jeremiasadrian/MIB_sistema_p_realimentacion_haptica/Esquematicos-y-PCB/Proyecto_KiCAD_Control-y-fuente-de-corriente/bom/BOM_Planilla.ods

N.º | Referencias | Valor | Footprint | Cantidad | Datasheet | Código Proveedor
1 | R1, R5 | 10k | R_Axial_DIN0207_L6.3mm_D2.5mm_P10.16mm_Horizontal | 2
2 | R2 | 22k | R_Axial_DIN0207_L6.3mm_D2.5mm_P10.16mm_Horizontal | 1
3 | R3 | 6k8 | R_Axial_DIN0207_L6.3mm_D2.5mm_P10.16mm_Horizontal | 1
4 | R4 | 47k | R_Axial_DIN0207_L6.3mm_D2.5mm_P10.16mm_Horizontal | 1
5 | R6 | 3k3 | R_Axial_DIN0207_L6.3mm_D2.5mm_P10.16mm_Horizontal | 1
6 | D1, D2 | 1N4148 | D_DO-41_SOD81_P7.62mm_Horizontal | 2
7 | U1 | LCD-016N002L | LCD_pinsonly | 1
8 | U2 | PSoC4_kit049_(CY8C4245AXI-483) | PinSocket_2x22_P2.54mm_Vertical_2 | 1
9 | U3 | TL082 | DIP-8_W10.16mm_LongPads | 1
10 | SW1, SW2 | SW_Push | SW_PUSH_6mm_H7.3mm | 2
11 | Q1, Q4, Q6 | BF422 | BF42X | 3
12 | Q2, Q3, Q5 | BF421 | BF42X | 3
13 | RV1, RV4 | 5k | Potentiometer_Bourns_3296W_Vertical | 2
14 | RV2 | 2k | Potentiometer_Bourns_3296W_Vertical | 1
15 | RV3 | 10k | Potentiometer_Bourns_3296W_Vertical | 1
16 | J1, J5 | Conn_01x01_Male | PinHeader_1x01_P2.54mm_Horizontal | 2
17 | J2, J3 | Screw_Terminal_01x01 | TerminalBLock_bornier-1_P5.08mm | 2
18 | J4 | Screw_Terminal_01x04 | TerminalBlock_bornier-4_P5.08mm | 1
