jeremiasadrian/MIB_sistema_p_realimentacion_haptica/Esquematicos-y-PCB/Proyecto_KiCAD_Control-y-fuente-de-corriente/Control_Fuente_de_Corrientes.step

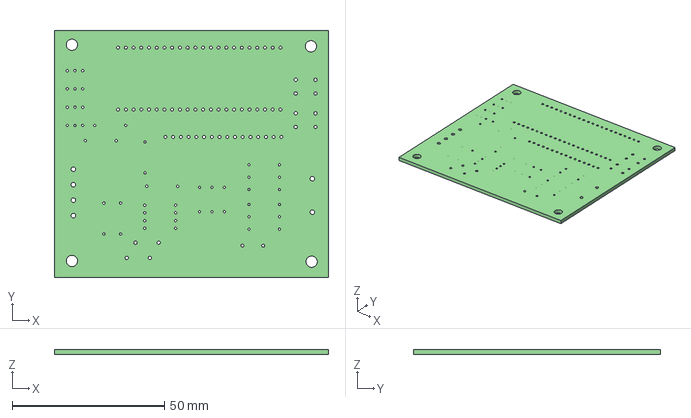
[picture p9: CAD file, 2024-03-17]
Esquematicos-y-PCB/Proyecto_KiCAD_Control-y-fuente-de-corriente/Control_Fuente_de_Corrientes.step
90.0 x 81.2 x 1.60 mm
