jeremiasadrian/MIB_sistema_p_realimentacion_haptica/Resultados/Pruebas/Caracterización del Nucleo de Ferrita (grande ATX).xlsx

N | N^2 | L
45 | 2025 | 4
65 | 4225 | 8.92
85 | 7225 | 17.75
105 | 11025 | 29.66
125 | 15625 | 36
150 | 22500 | 54
175 | 30625 | 76.9
200 | 40000 | 104
240 | 57600 | 162
