jeremiasadrian/MIB_sistema_p_realimentacion_haptica/Resultados/Pruebas/Regulación de Fuente de AT.xlsx

Relevamiento con ARD-UNO a 500Hz y 70% de DC.
N° | Vo+ (V) | Io (mA) | Rl (calc) | Po (mW) | Icc (A) | Vcc (V) | Pcc (W) | V+ (Rs) | V- (Rs)
1 | 317 | 1.67 | 189820.3593 | 529.39 | 0.28 | 12 | 3.36 | 2.16 | 2.64 | MAX
2 | 275 | 2.03 | 135467.9803 | 558.25 | 0.39 | 12 | 4.68 | 3.6 | 3.76
3 | 247 | 2.22 | 111261.2613 | 548.34 | 0.46 | 12 | 5.52 | 4.8 | 4.6 | Rango útil
4 | 217 | 2.4 | 90416.66667 | 520.8 | 0.59 | 12 | 7.08 | 6.2 | 5.8
5 | 191 | 2.59 | 73745.17375 | 494.69 | 0.64 | 12 | 7.68 | 6.8 | 6.2
6 | 166 | 2.86 | 58041.95804 | 474.76 | 0.7 | 12 | 8.4 | 7.4 | 7
7 | 117 | 3.46 | 33815.0289 | 404.82 | 0.8 | 12 | 9.6 | 8.4 | 8.2
8 | 93 | 4.05 | 22962.96296 | 376.65 | 0.84 | 12 | 10.08 | 8.8 | 8.8
9 | 0.75 | 12.73 | 58.91594658 | 9.5475 | 0.99 | 12 | 11.88 | 10.2 | 10.8 | MIN
Relevamiento con SG3525 (lazo abierto) a 85Hz y 300us de DT.
N° | Vo+ (V) | Io (mA) | Rl (calc) | Po (mW) | Icc (A) | Vcc (V) | Pcc (W) | V+ (Rs) | V- (Rs)
1 | 313 | 1.29 | 242635.6589 | 403.77 | 0.4 | 12 | 4.8 | 2.2 | 2.2 | MAX | picos de 8
2 | 304 | 1.52 | 200000 | 462.08 | 0.414 | 12 | 4.968 | 3 | 2.5
3 | 263 | 2.02 | 130198.0198 | 531.26 | 0.58 | 12 | 6.96 | 5 | 4 | Rango útil
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
