jeremiasadrian/MIB_sistema_p_realimentacion_haptica/Resultados/Pruebas/Respuesta de Opto 4N26A.xlsx

Punto | Vba (volt) | Ii (uA) | Vc (volt)
1 | 1 | 67.5 | 12.93
2 | 1.1 | 102 | 12.81
3 | 1.2 | 145.8 | 12.64
4 | 1.3 | 186.6 | 12.43
5 | 1.4 | 226.5 | 12.23
6 | 1.5 | 271.5 | 11.92
7 | 1.6 | 324.8 | 11.55
8 | 1.7 | 377.7 | 11.18
9 | 1.8 | 418.6 | 10.88
10 | 1.9 | 465.8 | 10.5
11 | 2 | 504.7 | 10.19
12 | 2.1 | 554.1 | 9.76
13 | 2.2 | 604 | 9.33
14 | 2.3 | 657 | 8.84
15 | 2.4 | 704 | 8.42
16 | 2.5 | 745 | 8.04
17 | 2.6 | 798 | 7.52
18 | 2.7 | 844 | 7.09
19 | 2.8 | 894 | 6.6
20 | 2.9 | 940 | 6.16
21 | 3 | 990 | 5.68
22 | 3.1 | 1038 | 5.2
23 | 3.2 | 1089 | 4.72
24 | 3.3 | 1130 | 4.32
25 | 3.4 | 1189 | 3.76
26 | 3.5 | 1233 | 3.33
27 | 3.6 | 1273 | 2.94
28 | 3.7 | 1326 | 2.4
29 | 3.8 | 1384 | 1.9
30 | 3.9 | 1426 | 1.48
31 | 4 | 1480 | 0.98
32 | 4.1 | 1521 | 0.72
33 | 4.2 | 1565 | 0.59
34 | 4.3 | 1620 | 0.52
35 | 4.4 | 1680 | 0.47
36 | 4.5 | 1721 | 0.44
37 | 4.6 | 1767 | 0.42
38 | 4.7 | 1826 | 0.39
39 | 4.8 | 1865 | 0.37
40 | 4.9 | 1922 | 0.35
41 | 5 | 1968 | 0.34
