jeremiasadrian/MIB_sistema_p_realimentacion_haptica/Resultados/Pruebas/Relevamiento para linealización FSR.xlsx

n | Pn (gr) | PnT (gr) | Rn | Rcn
1 | 0 | 7.54 | 8300000 | - | Peso de la plataforma (gr):
2 | 2 | 9.54 | 1100000 | - | 7.54
3 | 5 | 12.54 | 160000 | 989
4 | 10 | 17.54 | 88000 | 983
5 | 20 | 27.54 | 60500 | 977
6 | 50 | 57.54 | 21300 | 954
7 | 70 | 77.54 | 15900 | 944
8 | 100 | 107.54 | 13500 | 923
9 | 150 | 157.54 | 10000 | -
10 | 200 | 207.54 | 7300 | -
11 | 300 | 307.54 | 6200 | -
12 | 400 | 407.54 | 5350 | -
13 | 500 | 507.54 | 4650 | -
14 | 600 | 607.54 | 4250 | -
Linealización pasiva con R paralelo.
Ra | 160000
Rb | 13500
Rj | 60500
p | 0.84
 |  | RL | 984.0
Linealización activa con divisor resistivo.
n | Pn (gr) | PnT (gr) | V1n (1,014M pull-u) | V1n (1,014M pull-d) | V2n (476k pull-u) | V2n (476k pull-d) | V3n (99,3k pull-u) | V3n (99,3k pull-d)
1 | 0 | 0 | 4.583 | 0 | 4.796 | 0 | 4.956 | 0
2 | 0 | 7.54 | 1.6 | 3.9 | 1.83 | 2.7 | 3.55 | 2
3 | 2 | 9.54 | 1.25 | 4.34 | 1.2 | 3.5 | 2.95 | 2.6
4 | 5 | 12.54 | 0.8 | 4.59 | 0.8 | 3.95 | 2.36 | 3
5 | 10 | 17.54 | 0.52 | 4.71 | 0.56 | 4.36 | 2.18 | 3.29
6 | 20 | 27.54 | 0.315 | 4.76 | 0.39 | 4.59 | 1.42 | 3.68
7 | 50 | 57.54 | 0.134 | 4.86 | 0.26 | 4.73 | 0.95 | 4
8 | 100 | 107.54 | 0.088 | 4.92 | 0.173 | 4.865 | 0.67 | 4.3
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
