jeremiasadrian/MIB_sistema_p_realimentacion_haptica/Resultados/Pruebas/RelevVDAC 1SEG.xls

Sheet: Vo (t=1seg)
recFunction | recValue | recUnit | recTime
DCV | 0 | mV | 22:14:58
DCV | 3.2 | mV | 22:14:58
DCV | 6.2 | mV | 22:14:59
DCV | 6.6 | mV | 22:15:00
DCV | 6.9 | mV | 22:15:00
DCV | 7.4 | mV | 22:15:01
DCV | 7.5 | mV | 22:15:01
DCV | 7.6 | mV | 22:15:02
DCV | 7.7 | mV | 22:15:03
DCV | 7.7 | mV | 22:15:03
DCV | 7.8 | mV | 22:15:04
DCV | 7.8 | mV | 22:15:04
DCV | 8 | mV | 22:15:05
DCV | 8.2 | mV | 22:15:06
DCV | 8.6 | mV | 22:15:06
DCV | 9.1 | mV | 22:15:07
DCV | 11.3 | mV | 22:15:07
DCV | 14.9 | mV | 22:15:08
DCV | 21.5 | mV | 22:15:09
DCV | 36.7 | mV | 22:15:09 |  | 15.2
DCV | 46.7 | mV | 22:15:10 |  | 10
DCV | 59.2 | mV | 22:15:10 |  | 12.5
DCV | 70.3 | mV | 22:15:11 |  | 11.1
DCV | 82.1 | mV | 22:15:11 |  | 11.8
DCV | 99.7 | mV | 22:15:12 |  | 17.6
DCV | 115.9 | mV | 22:15:13 |  | 16.2
DCV | 123.4 | mV | 22:15:13 |  | 7.5
DCV | 141.3 | mV | 22:15:14 |  | 17.9
DCV | 154.7 | mV | 22:15:14 |  | 13.4
DCV | 164.2 | mV | 22:15:15 |  | 9.5
DCV | 176.5 | mV | 22:15:16 |  | 12.3
DCV | 185.4 | mV | 22:15:16 |  | 8.9
DCV | 201.4 | mV | 22:15:17 |  | 16
DCV | 213.7 | mV | 22:15:17 |  | 12.3
DCV | 231 | mV | 22:15:18 |  | 17.3
DCV | 235.1 | mV | 22:15:19 |  | 4.1
DCV | 252.5 | mV | 22:15:19 |  | 17.4
DCV | 265.4 | mV | 22:15:20 |  | 12.9
DCV | 277.4 | mV | 22:15:20 |  | 12
DCV | 287.6 | mV | 22:15:21 |  | 10.2
DCV | 299.9 | mV | 22:15:21 |  | 12.3
DCV | 317.2 | mV | 22:15:22 |  | 17.3
DCV | 331.4 | mV | 22:15:23 |  | 14.2
DCV | 338.9 | mV | 22:15:23 |  | 7.5
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
DCV | 4,654 | V | 22:27:32
DCV | 4,655 | V | 22:27:33
DCV | 4,677 | V | 22:27:33
DCV | 4,677 | V | 22:27:34
DCV | 4,697 | V | 22:27:35
DCV | 4,697 | V | 22:27:35
DCV | 4,717 | V | 22:27:36
DCV | 4,718 | V | 22:27:36
DCV | 4,737 | V | 22:27:37
DCV | 4,739 | V | 22:27:38
DCV | 4,757 | V | 22:27:38

Sheet: Ii (t=1seg)
recItem | recFunction | recValue | recUnit | recTime
1 | DCA | 2.2 | uA | 21:57:15
2 | DCA | 2.2 | uA | 21:57:16
3 | DCA | 4.5 | uA | 21:57:16 |  | 2.3
4 | DCA | 6.3 | uA | 21:57:17 |  | 1.8
5 | DCA | 6.5 | uA | 21:57:17
6 | DCA | 9.1 | uA | 21:57:18 |  | 2.6
7 | DCA | 11.6 | uA | 21:57:19 |  | 2.5
8 | DCA | 11.6 | uA | 21:57:19
9 | DCA | 14 | uA | 21:57:20 |  | 2.4
10 | DCA | 14 | uA | 21:57:20
11 | DCA | 16.3 | uA | 21:57:21 |  | 2.3
12 | DCA | 16.3 | uA | 21:57:22
13 | DCA | 18.6 | uA | 21:57:22 |  | 2.3
14 | DCA | 18.6 | uA | 21:57:23
15 | DCA | 20.9 | uA | 21:57:23 |  | 2.3
16 | DCA | 23.4 | uA | 21:57:24 |  | 2.5
17 | DCA | 23.4 | uA | 21:57:25
18 | DCA | 25 | uA | 21:57:25 |  | 1.6
19 | DCA | 28 | uA | 21:57:26 |  | 3
20 | DCA | 28 | uA | 21:57:26
21 | DCA | 30.4 | uA | 21:57:27 |  | 2.4
22 | DCA | 30.4 | uA | 21:57:27
23 | DCA | 32.8 | uA | 21:57:28 |  | 2.4
24 | DCA | 32.8 | uA | 21:57:28
25 | DCA | 35.1 | uA | 21:57:29 |  | 2.3
26 | DCA | 35.1 | uA | 21:57:30
27 | DCA | 37.5 | uA | 21:57:30 |  | 2.4
28 | DCA | 39.8 | uA | 21:57:31 |  | 2.3
29 | DCA | 39.8 | uA | 21:57:31
30 | DCA | 42.2 | uA | 21:57:32 |  | 2.4
31 | DCA | 43.7 | uA | 21:57:33 |  | 1.5
32 | DCA | 43.9 | uA | 21:57:33 |  | 0.2
33 | DCA | 46.6 | uA | 21:57:34 |  | 2.7
34 | DCA | 46.7 | uA | 21:57:34
35 | DCA | 48.9 | uA | 21:57:35 |  | 2.2
36 | DCA | 49 | uA | 21:57:36
37 | DCA | 51.6 | uA | 21:57:36 |  | 2.6
38 | DCA | 51.6 | uA | 21:57:37
39 | DCA | 54 | uA | 21:57:37 |  | 2.4
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
1536 | DCA | 297.2 | uA | 22:12:11
1537 | DCA | 299.5 | uA | 22:12:11 |  | 2.3
1538 | DCA | 301.4 | uA | 22:12:12 | mitad del cuarto ciclo | 1.9 | 2.21 | uA
 |  |  |  |  |  |  | Ii medida |  | Vo calculada
 |  |  | FIN DE LA MEDICIÓN |  |  |  | 2.23 | uA | 14.80 | mV
