jeremiasadrian/MIB_sistema_p_realimentacion_haptica/Resultados/Pruebas/RelevVDAC(Ii).XLS

Sheet: ListData
recItem | recFunction | recValue | recUnit | recTime | recItem | recFunction | recValue | recUnit | recTime
1 | DCA | 000.0 | uA | 16:30:11 | 1 | DCV | 008.9 | mV | 16:11:28
2 | DCA | 000.0 | uA | 16:30:11 | 2 | DCV | 008.9 | mV | 16:11:29
3 | DCA | 000.0 | uA | 16:30:12 | 3 | DCV | 008.9 | mV | 16:11:29 | Mediciones realizadas con una Ri de 589 Ohm.
4 | DCA | -000.0 | uA | 16:30:13 | 4 | DCV | 008.9 | mV | 16:11:30
5 | DCA | 000.0 | uA | 16:30:13 | 5 | DCV | 008.9 | mV | 16:11:31
6 | DCA | 000.0 | uA | 16:30:14 | 6 | DCV | 008.9 | mV | 16:11:31
7 | DCA | 002.0 | uA | 16:30:14 | 7 | DCV | 008.8 | mV | 16:11:32
8 | DCA | 004.5 | uA | 16:30:15 | 8 | DCV | 008.8 | mV | 16:11:32
9 | DCA | 006.8 | uA | 16:30:16 | 9 | DCV | 009.1 | mV | 16:11:33
10 | DCA | 009.3 | uA | 16:30:16 | 10 | DCV | 009.4 | mV | 16:11:33
11 | DCA | 013.1 | uA | 16:30:17 | 11 | DCV | 014.2 | mV | 16:11:34
12 | DCA | 016.3 | uA | 16:30:17 | 12 | DCV | 039.4 | mV | 16:11:35
13 | DCA | 018.4 | uA | 16:30:18 | 13 | DCV | 052.8 | mV | 16:11:35
14 | DCA | 020.9 | uA | 16:30:18 | 14 | DCV | 085.6 | mV | 16:11:36
15 | DCA | 023.6 | uA | 16:30:19 | 15 | DCV | 116.1 | mV | 16:11:36
16 | DCA | 025.8 | uA | 16:30:20 | 16 | DCV | 132.6 | mV | 16:11:37
17 | DCA | 029.9 | uA | 16:30:20 | 17 | DCV | 164.4 | mV | 16:11:38
18 | DCA | 032.9 | uA | 16:30:21 | 18 | DCV | 193.6 | mV | 16:11:38
19 | DCA | 035.1 | uA | 16:30:21 | 19 | DCV | 222.4 | mV | 16:11:39
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
 |  |  |  |  | 1291 | DCV | 4.682 | V | 16:24:12
 |  |  |  |  | 1292 | DCV | 4.700 | V | 16:24:12
 |  |  |  |  | 1293 | DCV | 4.722 | V | 16:24:13
 |  |  |  |  | 1294 | DCV | 4.741 | V | 16:24:13
 |  |  |  |  | 1295 | DCV | 4.768 | V | 16:24:14
 |  |  |  |  | 1296 | DCV | 4.800 | V | 16:24:15
 |  |  |  |  | 1297 | DCV | 4.818 | V | 16:24:15
 |  |  |  |  | 1298 | DCV | 4.840 | V | 16:24:16
 |  |  |  |  | 1299 | DCV | 4.860 | V | 16:24:16
 |  |  |  |  | 1300 | DCV | 4.878 | V | 16:24:17
 |  |  |  |  | 1301 | DCV | 4.919 | V | 16:24:18
 |  |  |  |  | 1302 | DCV | 4.932 | V | 16:24:18
 |  |  |  |  | 1303 | DCV | 4.955 | V | 16:24:19
 |  |  |  |  | 1304 | DCV | 4.955 | V | 16:24:19
 |  |  |  |  | 1305 | DCV | 4.956 | V | 16:24:20
 |  |  |  |  | 1306 | DCV | 4.957 | V | 16:24:21
 |  |  |  |  | 1307 | DCV | 2.599 | V | 16:24:21
 |  |  |  |  | 1308 | DCV | 121.9 | mV | 16:24:27
 |  |  |  |  | 1309 | DCV | 137.8 | mV | 16:24:27

Sheet: period 1
recItem | recFunction | recValue | recUnit | recTime | recFunction | recValue | recUnit | recTime
1 | DCA | 0 | uA | 16:30:14 | DCV | 8.8 | mV | 16:11:32
2 | DCA | 2 | uA | 16:30:14 | DCV | 9.1 | mV | 16:11:33
3 | DCA | 4.5 | uA | 16:30:15 | DCV | 9.4 | mV | 16:11:33 | x | y
4 | DCA | 6.8 | uA | 16:30:16 | DCV | 14.2 | mV | 16:11:34 |  | 4.8 |  |  | 2.5
5 | DCA | 9.3 | uA | 16:30:16 | DCV | 39.4 | mV | 16:11:35 |  | 25.2 |  |  | 2.3
6 | DCA | 13.1 | uA | 16:30:17 | DCV | 52.8 | mV | 16:11:35 |  | 13.4 |  |  | 2.5
7 | DCA | 16.3 | uA | 16:30:17 | DCV | 85.6 | mV | 16:11:36 |  | 32.8 |  |  | 3.8
8 | DCA | 18.4 | uA | 16:30:18 | DCV | 116.1 | mV | 16:11:36 |  | 30.5 |  |  | 3.2
9 | DCA | 20.9 | uA | 16:30:18 | DCV | 132.6 | mV | 16:11:37 |  | 16.5 |  |  | 2.1
10 | DCA | 23.6 | uA | 16:30:19 | DCV | 164.4 | mV | 16:11:38 |  | 31.8 |  |  | 2.5
11 | DCA | 25.8 | uA | 16:30:20 | DCV | 193.6 | mV | 16:11:38 |  | 29.2 |  |  | 2.7
12 | DCA | 29.9 | uA | 16:30:20 | DCV | 222.4 | mV | 16:11:39 |  | 28.8 |  |  | 2.2
13 | DCA | 32.9 | uA | 16:30:21 | DCV | 238.3 | mV | 16:11:39 |  | 15.9 |  |  | 4.1
14 | DCA | 35.1 | uA | 16:30:21 | DCV | 268 | mV | 16:11:40 |  | 29.7 |  |  | 3
15 | DCA | 37.4 | uA | 16:30:22 | DCV | 300.4 | mV | 16:11:41 |  | 32.4 |  |  | 2.2
16 | DCA | 39.8 | uA | 16:30:23 | DCV | 313.3 | mV | 16:11:41 |  | 12.9 |  |  | 2.3
17 | DCA | 41.7 | uA | 16:30:23 | DCV | 348.1 | mV | 16:11:42 |  | 34.8 |  |  | 2.4
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
219 | DCA | 600.7 | uA | 16:32:21 | 23.497 | mV | 3.54 | uA | 2.750 | uA | 18.23 | mV | 2.4
 |  |  |  |  | Según valor de resistencias y resolución del IDAC |  |  |  | Según resolución del IDAC
 |  |  |  |  |  |  |  |  |  | 2.400 | uA
 |  |  |  |  |  | 15.900 | mV

Sheet: periodo 2
446 | DCA | 004.5 | uA | 16:34:31 | 442 | DCV | 006.4 | mV | 16:15:49
447 | DCA | 006.2 | uA | 16:34:32 | 443 | DCV | 008.1 | mV | 16:15:49
448 | DCA | 009.2 | uA | 16:34:33 | 444 | DCV | 009.3 | mV | 16:15:50
449 | DCA | 012.5 | uA | 16:34:33 | 445 | DCV | 013.5 | mV | 16:15:50
450 | DCA | 014.0 | uA | 16:34:34 | 446 | DCV | 022.8 | mV | 16:15:51
451 | DCA | 018.6 | uA | 16:34:34 | 447 | DCV | 049.6 | mV | 16:15:52
452 | DCA | 021.0 | uA | 16:34:35 | 448 | DCV | 081.8 | mV | 16:15:52
453 | DCA | 023.4 | uA | 16:34:36 | 449 | DCV | 109.7 | mV | 16:15:53
454 | DCA | 025.7 | uA | 16:34:36 | 450 | DCV | 127.9 | mV | 16:15:54
455 | DCA | 028.0 | uA | 16:34:37 | 451 | DCV | 155.6 | mV | 16:15:54
456 | DCA | 030.3 | uA | 16:34:37 | 452 | DCV | 187.7 | mV | 16:15:55
457 | DCA | 035.2 | uA | 16:34:38 | 453 | DCV | 203.9 | mV | 16:15:55
458 | DCA | 036.9 | uA | 16:34:39 | 454 | DCV | 234.3 | mV | 16:15:56
459 | DCA | 039.8 | uA | 16:34:39 | 455 | DCV | 249.1 | mV | 16:15:56
460 | DCA | 042.1 | uA | 16:34:40 | 456 | DCV | 282.1 | mV | 16:15:57
461 | DCA | 044.5 | uA | 16:34:40 | 457 | DCV | 312.4 | mV | 16:15:58
462 | DCA | 049.1 | uA | 16:34:41 | 458 | DCV | 329.3 | mV | 16:15:58
463 | DCA | 049.1 | uA | 16:34:41 | 459 | DCV | 359.4 | mV | 16:15:59
464 | DCA | 053.9 | uA | 16:34:42 | 460 | DCV | 374.6 | mV | 16:15:59
465 | DCA | 056.2 | uA | 16:34:43 | 461 | DCV | 409.6 | mV | 16:16:00
466 | DCA | 058.6 | uA | 16:34:43 | 462 | DCV | 436.6 | mV | 16:16:01
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
656 | DCA | 584.1 | uA | 16:36:35 | 652 | DCV | 4.935 | V | 16:17:53
657 | DCA | 584.1 | uA | 16:36:35 | 653 | DCV | 4.956 | V | 16:17:54
658 | DCA | 589.1 | uA | 16:36:36 | 654 | DCV | 4.956 | V | 16:17:55
659 | DCA | 591.4 | uA | 16:36:36 | 655 | DCV | 4.957 | V | 16:17:55
660 | DCA | 593.6 | uA | 16:36:37
661 | DCA | 595.6 | uA | 16:36:38
662 | DCA | 600.7 | uA | 16:36:38

Sheet: periodo 3
664 | DCA | 002.2 | uA | 16:36:39 | 658 | DCV | 006.2 | mV | 16:17:57
665 | DCA | 003.8 | uA | 16:36:40 | 659 | DCV | 009.0 | mV | 16:17:58
666 | DCA | 006.8 | uA | 16:36:40 | 660 | DCV | 009.4 | mV | 16:17:58
667 | DCA | 010.8 | uA | 16:36:41 | 661 | DCV | 012.7 | mV | 16:17:59
668 | DCA | 011.0 | uA | 16:36:42 | 662 | DCV | 029.6 | mV | 16:17:59
669 | DCA | 016.3 | uA | 16:36:42 | 663 | DCV | 058.1 | mV | 16:18:00
670 | DCA | 018.6 | uA | 16:36:43 | 664 | DCV | 070.2 | mV | 16:18:01
671 | DCA | 021.0 | uA | 16:36:43 | 665 | DCV | 103.7 | mV | 16:18:01
672 | DCA | 023.5 | uA | 16:36:44 | 666 | DCV | 134.5 | mV | 16:18:02
673 | DCA | 025.7 | uA | 16:36:45 | 667 | DCV | 153.0 | mV | 16:18:02
674 | DCA | 028.2 | uA | 16:36:45 | 668 | DCV | 183.7 | mV | 16:18:03
675 | DCA | 032.9 | uA | 16:36:46 | 669 | DCV | 216.9 | mV | 16:18:04
676 | DCA | 034.6 | uA | 16:36:46 | 670 | DCV | 230.9 | mV | 16:18:04
677 | DCA | 037.4 | uA | 16:36:47 | 671 | DCV | 262.7 | mV | 16:18:05
678 | DCA | 039.9 | uA | 16:36:48 | 672 | DCV | 293.3 | mV | 16:18:05
679 | DCA | 042.2 | uA | 16:36:48 | 673 | DCV | 308.3 | mV | 16:18:06
680 | DCA | 046.2 | uA | 16:36:49 | 674 | DCV | 340.0 | mV | 16:18:07
681 | DCA | 049.2 | uA | 16:36:49 | 675 | DCV | 369.2 | mV | 16:18:07
682 | DCA | 051.6 | uA | 16:36:50 | 676 | DCV | 385.7 | mV | 16:18:08
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
