jeremiasadrian/MIB_sistema_p_realimentacion_haptica/Resultados/Pruebas/RelevVDAC(Ii)1SEG.XLS

recItem | recFunction | recValue | recUnit | recTime
1 | DCA | 000.0 | uA | 21:57:11
2 | DCA | 000.0 | uA | 21:57:12
3 | DCA | 000.0 | uA | 21:57:12
4 | DCA | 000.0 | uA | 21:57:13
5 | DCA | -000.0 | uA | 21:57:13
6 | DCA | 000.0 | uA | 21:57:14
7 | DCA | -000.0 | uA | 21:57:15
8 | DCA | 002.2 | uA | 21:57:15
9 | DCA | 002.2 | uA | 21:57:16
10 | DCA | 004.5 | uA | 21:57:16
11 | DCA | 006.3 | uA | 21:57:17
12 | DCA | 006.5 | uA | 21:57:17
13 | DCA | 009.1 | uA | 21:57:18
14 | DCA | 011.6 | uA | 21:57:19
15 | DCA | 011.6 | uA | 21:57:19
16 | DCA | 014.0 | uA | 21:57:20
17 | DCA | 014.0 | uA | 21:57:20
18 | DCA | 016.3 | uA | 21:57:21
19 | DCA | 016.3 | uA | 21:57:22
20 | DCA | 018.6 | uA | 21:57:22
21 | DCA | 018.6 | uA | 21:57:23
22 | DCA | 020.9 | uA | 21:57:23
23 | DCA | 023.4 | uA | 21:57:24
24 | DCA | 023.4 | uA | 21:57:25
25 | DCA | 025.0 | uA | 21:57:25
26 | DCA | 028.0 | uA | 21:57:26
27 | DCA | 028.0 | uA | 21:57:26
28 | DCA | 030.4 | uA | 21:57:27
29 | DCA | 030.4 | uA | 21:57:27
30 | DCA | 032.8 | uA | 21:57:28
31 | DCA | 032.8 | uA | 21:57:28
32 | DCA | 035.1 | uA | 21:57:29
33 | DCA | 035.1 | uA | 21:57:30
34 | DCA | 037.5 | uA | 21:57:30
35 | DCA | 039.8 | uA | 21:57:31
36 | DCA | 039.8 | uA | 21:57:31
37 | DCA | 042.2 | uA | 21:57:32
38 | DCA | 043.7 | uA | 21:57:33
39 | DCA | 043.9 | uA | 21:57:33
40 | DCA | 046.6 | uA | 21:57:34
41 | DCA | 046.7 | uA | 21:57:34
42 | DCA | 048.9 | uA | 21:57:35
43 | DCA | 049.0 | uA | 21:57:36
44 | DCA | 051.6 | uA | 21:57:36
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
1538 | DCA | 292.3 | uA | 22:12:08
1539 | DCA | 292.3 | uA | 22:12:08
1540 | DCA | 294.7 | uA | 22:12:09
1541 | DCA | 294.7 | uA | 22:12:10
1542 | DCA | 297.2 | uA | 22:12:10
1543 | DCA | 297.2 | uA | 22:12:11
1544 | DCA | 299.5 | uA | 22:12:11
1545 | DCA | 301.4 | uA | 22:12:12
