jeremiasadrian/MIB_sistema_p_realimentacion_haptica/Resultados/Pruebas/RelevVDAC(Ii)5SEG.XLS

recItem | recFunction | recValue | recUnit | recTime
1 | DCA | 546.5 | uA | 02:39:40
2 | DCA | 546.5 | uA | 02:39:40
3 | DCA | 546.5 | uA | 02:39:41
4 | DCA | 546.5 | uA | 02:39:41
5 | DCA | 546.6 | uA | 02:39:42
6 | DCA | 546.5 | uA | 02:39:43
7 | DCA | 546.5 | uA | 02:39:43
8 | DCA | 546.4 | uA | 02:39:44
9 | DCA | 546.4 | uA | 02:39:44
10 | DCA | 548.8 | uA | 02:39:45
11 | DCA | 548.8 | uA | 02:39:45
12 | DCA | 548.7 | uA | 02:39:46
13 | DCA | 548.7 | uA | 02:39:47
14 | DCA | 548.8 | uA | 02:39:47
15 | DCA | 548.8 | uA | 02:39:48
16 | DCA | 548.7 | uA | 02:39:48
17 | DCA | 548.7 | uA | 02:39:49
18 | DCA | 551.3 | uA | 02:39:50
19 | DCA | 551.2 | uA | 02:39:50
20 | DCA | 551.2 | uA | 02:39:51
21 | DCA | 551.3 | uA | 02:39:51
22 | DCA | 551.2 | uA | 02:39:52
23 | DCA | 551.2 | uA | 02:39:52
24 | DCA | 551.2 | uA | 02:39:53
25 | DCA | 551.3 | uA | 02:39:54
26 | DCA | 551.3 | uA | 02:39:54
27 | DCA | 553.9 | uA | 02:39:55
28 | DCA | 553.9 | uA | 02:39:55
29 | DCA | 553.9 | uA | 02:39:56
30 | DCA | 553.9 | uA | 02:39:57
31 | DCA | 553.9 | uA | 02:39:57
32 | DCA | 553.9 | uA | 02:39:58
33 | DCA | 553.9 | uA | 02:39:58
34 | DCA | 553.9 | uA | 02:39:59
35 | DCA | 553.9 | uA | 02:39:59
36 | DCA | 556.3 | uA | 02:40:00
37 | DCA | 556.3 | uA | 02:40:01
38 | DCA | 556.2 | uA | 02:40:01
39 | DCA | 556.2 | uA | 02:40:02
40 | DCA | 556.2 | uA | 02:40:02
41 | DCA | 556.2 | uA | 02:40:03
42 | DCA | 556.2 | uA | 02:40:03
43 | DCA | 556.2 | uA | 02:40:04
44 | DCA | 558.6 | uA | 02:40:05
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
695 | DCA | 131.9 | uA | 02:46:24
696 | DCA | 131.9 | uA | 02:46:24
697 | DCA | 131.9 | uA | 02:46:25
698 | DCA | 131.9 | uA | 02:46:25
699 | DCA | 134.3 | uA | 02:46:26
700 | DCA | 134.2 | uA | 02:46:27
701 | DCA | 134.2 | uA | 02:46:27
702 | DCA | 134.2 | uA | 02:46:28
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
