jeremiasadrian/MIB_sistema_p_realimentacion_haptica/Resultados/Imagenes/Capturas de Osciloscopio/Secunario de Alta 2.BMP

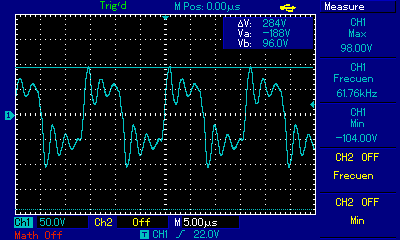
Resultados/Imagenes/Capturas de Osciloscopio/Secunario de Alta 2.BMP
