jeremiasadrian/MIB_sistema_p_realimentacion_haptica/Resultados/Imagenes/Capturas de Osciloscopio/Secundario de Alta 1.BMP

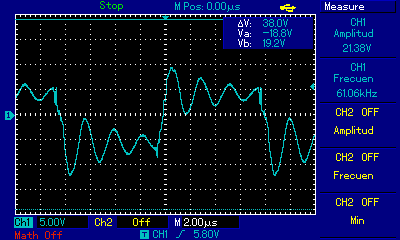
Resultados/Imagenes/Capturas de Osciloscopio/Secundario de Alta 1.BMP
