jeremiasadrian/MIB_sistema_p_realimentacion_haptica/Resultados/Imagenes/Capturas de Osciloscopio/Sobrepico en MOSFET 1.BMP

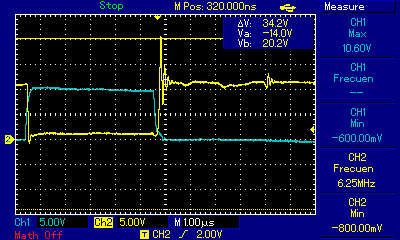
Resultados/Imagenes/Capturas de Osciloscopio/Sobrepico en MOSFET 1.BMP
