jeremiasadrian/MIB_sistema_p_realimentacion_haptica/Codigo-fuente/COD2_PSoC4_Electroestimulador/Electroestimulador.cydsn/CortexM0/ARM_GCC_541/Debug/LINK_options.txt

-Wl,--start-group -o "D:\\Tesis\ MIB\\Proyecto\ de\ Tesis\\TESIS\ -\ Desarrollo\\PSoC\\electroestimulador\\WorkspaceMIB2\\Electroestimulador.cydsn\\CortexM0\\ARM_GCC_541\\Debug\\Electroestimulador.elf" ".\\CortexM0\\ARM_GCC_541\\Debug\\Electroestimulador-main.o" ".\\CortexM0\\ARM_GCC_541\\Debug\\cyfitter_cfg.o" ".\\CortexM0\\ARM_GCC_541\\Debug\\cybootloader.o" ".\\CortexM0\\ARM_GCC_541\\Debug\\cymetadata.o" ".\\CortexM0\\ARM_GCC_541\\Debug\\Cm0Start.o" ".\\CortexM0\\ARM_GCC_541\\Debug\\Electroestimulador.a" -mcpu=cortex-m0 -mthumb -L "Generated_Source\\PSoC4" "-Wl,-Map,.\\CortexM0\\ARM_GCC_541\\Debug/Electroestimulador.map" -T "Generated_Source\\PSoC4\\cm0gcc.ld" -specs=nano.specs -Wl,--gc-sections -g -ffunction-sections -Og -ffat-lto-objects -Wl,--end-group
