jeremiasadrian/MIB_sistema_p_realimentacion_haptica/Esquematicos-y-PCB/Proyecto_KiCAD_Control-y-fuente-de-corriente/Botton.pdf

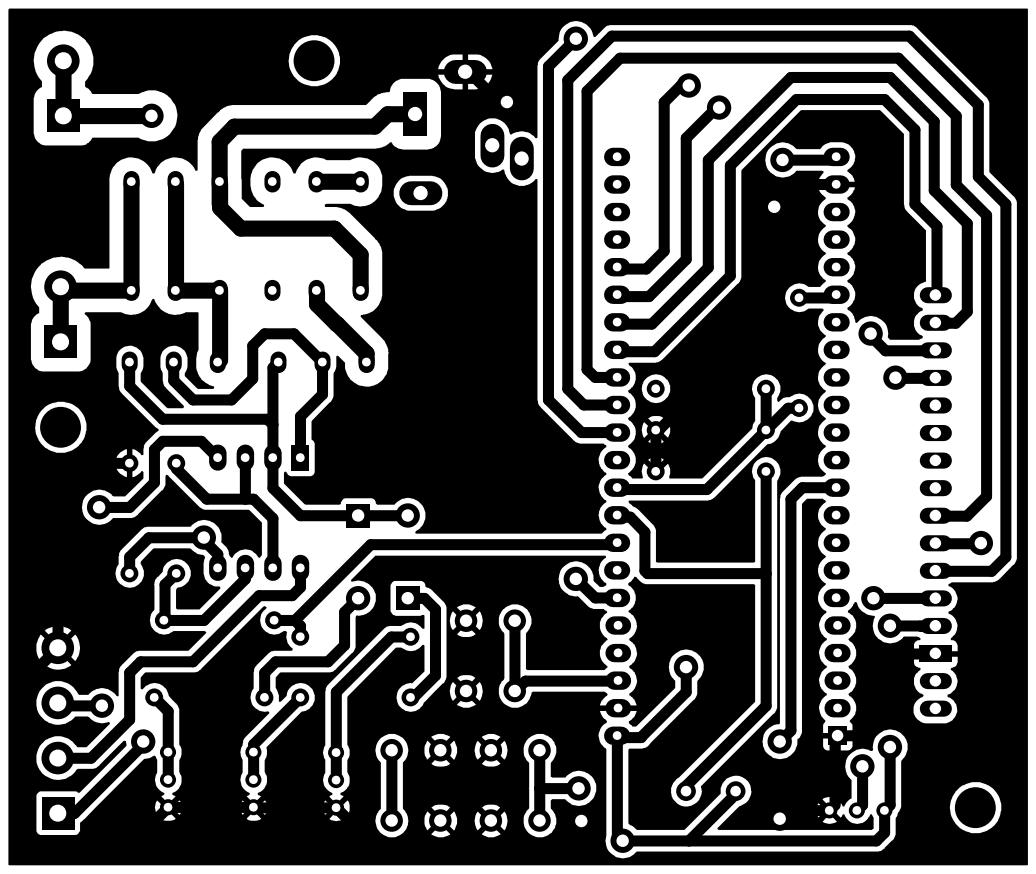
[picture p16: page 1]
