jeremiasadrian/MIB_sistema_p_realimentacion_haptica/Esquematicos-y-PCB/Proyecto_KiCAD_Control-y-fuente-de-corriente/Front.pdf

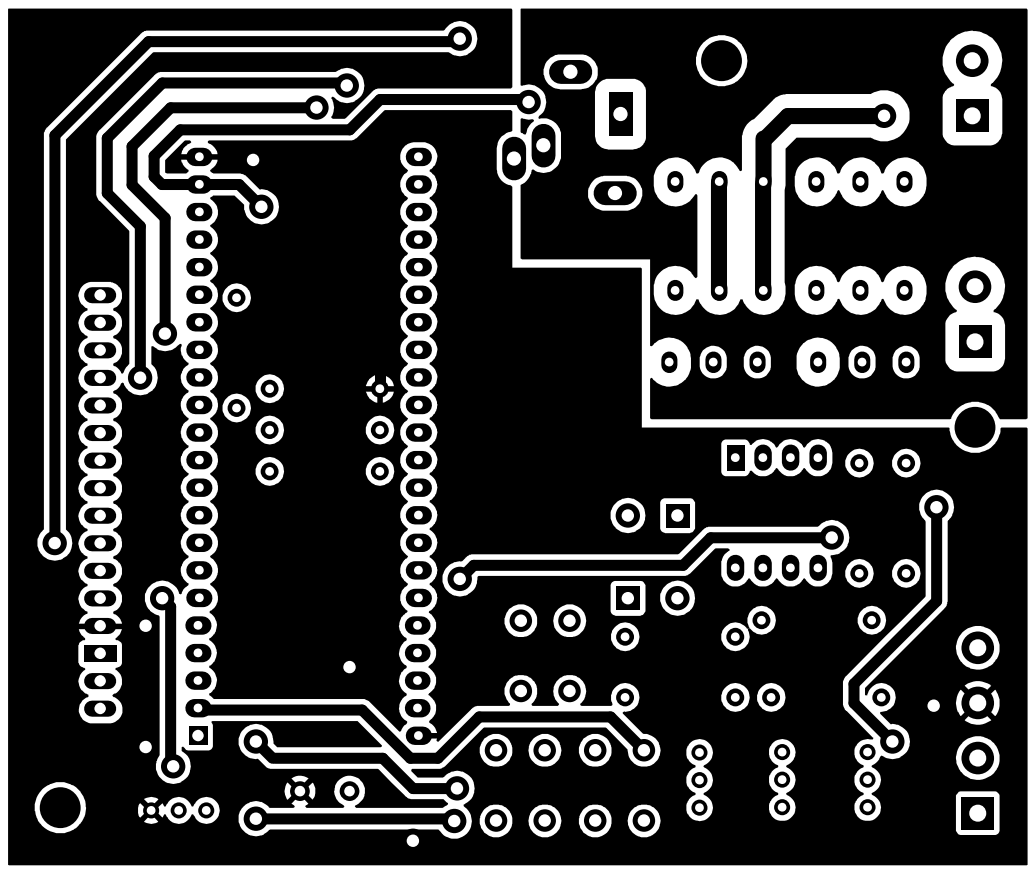
[picture p17: page 1]
