jeremiasadrian/MIB_sistema_p_realimentacion_haptica/Simulaciones/Fuente-de-corriente/SIM5_Fuente-de-Corrientes-c-interfaz-AO-(LTSpice-XVII).asc

D1: diode
D2: diode
I1: current; PULSE(612u 0 0 1n 1n 200u 1m 20)
I2: current; PULSE(0 612u 0 1n 1n 200u 1m 20)
Q1: npn
Q2: npn
Q4: npn
Q5: pnp
Q6: pnp
Q7: pnp
R1: res; 47k
R2: res; 22k
R3: res; 6.8k
R4: res; 12k
R5: res; 4k7
R6: res; 18k
R7: res; 60k
U1: LT6203
U2: LT6203
V1: voltage; 12
V4: voltage; 12
V5: voltage; 150
V6: voltage; 150
Named nets: 0, +12v, -12v, +150v, -150v
.tran 0 1 0.01 0.001
