jeremiasadrian/MIB_sistema_p_realimentacion_haptica/(list of files, drawings)

Other design files:
Simulaciones/Fuente-de-alimentación_(Proteus-8.13-SP1)/SIM1_Configuración-SG3525_(Proteus-8.13-SP1)/Fuente con SG3525 (UC2525).pdsprj
Simulaciones/Fuente-de-corriente/SIM3_Fuente_de_corriente_1-(Proteus-8.13-SP1).pdsprj
Simulaciones/Fuente-de-corriente/SIM4_Fuente_de_corriente_2-(Proteus-8.13-SP1).pdsprj
