jeremiasadrian/MIB_sistema_p_realimentacion_haptica/Esquematicos-y-PCB/Proyecto_KiCAD_Control-y-fuente-de-corriente/Control_Fuente_de_Corrientes.kicad_pcb

## KiCad design Esquematicos-y-PCB/Proyecto_KiCAD_Control-y-fuente-de-corriente/Control_Fuente_de_Corrientes.kicad_pcb (2024-03-17)

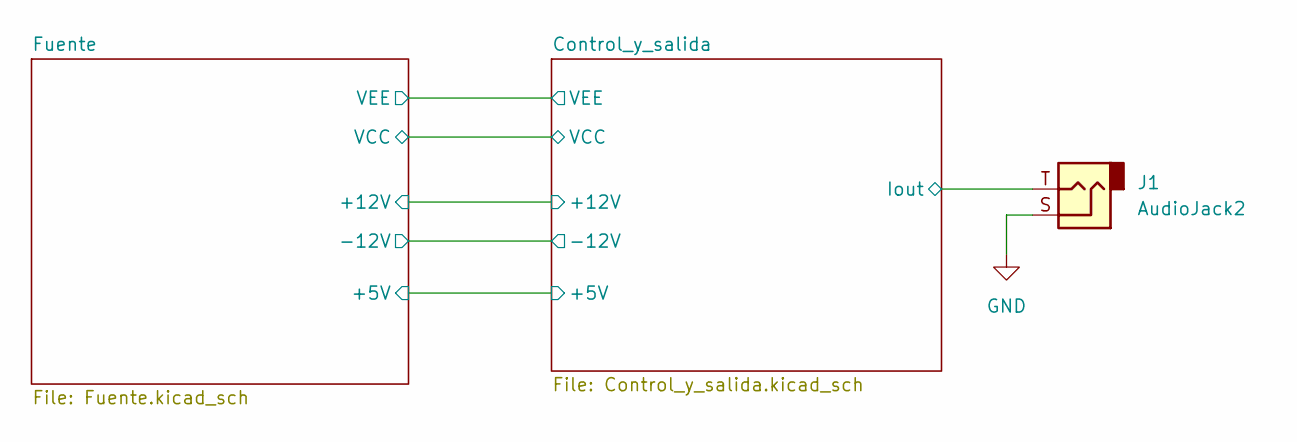
[picture p19: schematic Control_Fuente_de_Corrientes.kicad_sch, Electroestimulador_p_corriente]

Parts:
J1: AudioJack2; Jack_3.5mm_Ledino_KB3SPRS_Horizontal

Connections:
/Control_y_salida/Iout: J1.T; also elsewhere on the board
GND: J1.S; also elsewhere on the board

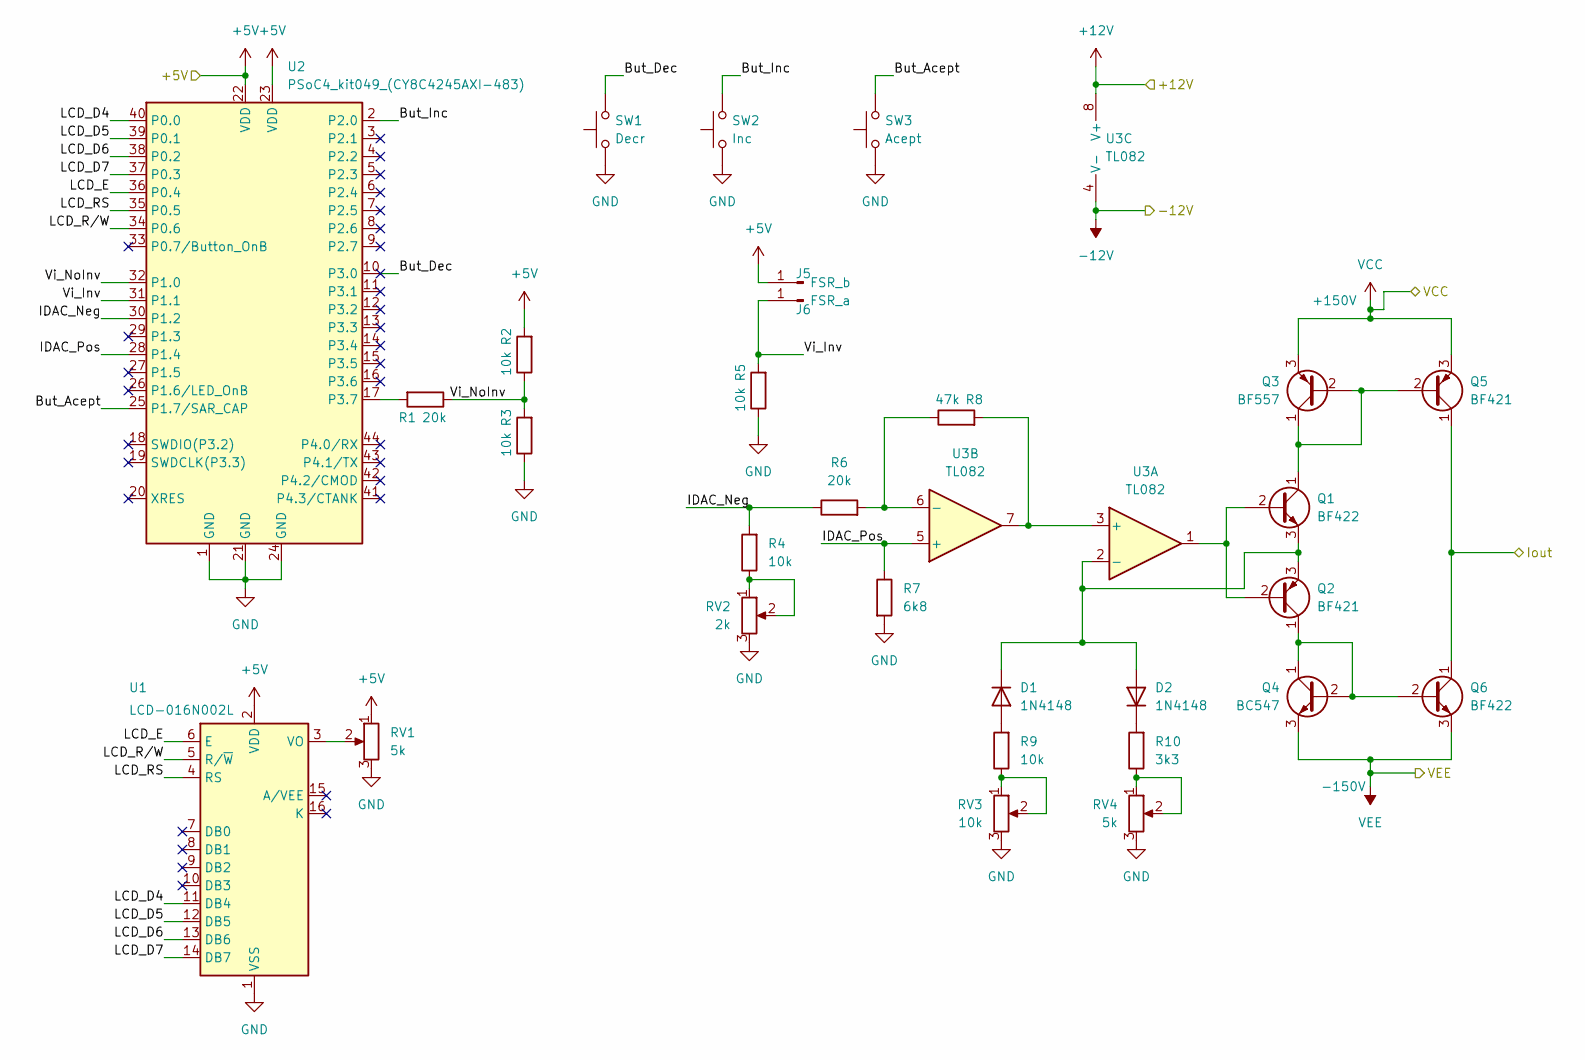
[picture p20: schematic Control_y_salida.kicad_sch, Control_con_PSoC4_y_Fuente_de_corriente]

Parts:
D1, D2: 1N4148; D_DO-41_SOD81_P7.62mm_Horizontal
J5: FSR_b; Pin_D0.9mm_L10.0mm_W2.4mm_FlatFork
J6: FSR_a; Pin_D0.9mm_L10.0mm_W2.4mm_FlatFork
Q1, Q6: BF422; BF42X
Q2, Q5: BF421; BF42X
Q3: BF557; BF42X
Q4: BC547; BF42X
R1, R6: 20k; R_Axial_DIN0207_L6.3mm_D2.5mm_P10.16mm_Horizontal; Tolerancia 1%
R2, R3, R4, R5, R9: 10k; R_Axial_DIN0207_L6.3mm_D2.5mm_P10.16mm_Horizontal; Tolerancia 1%
R7: 6k8; R_Axial_DIN0207_L6.3mm_D2.5mm_P10.16mm_Horizontal; Tolerancia 1%
R8: 47k; R_Axial_DIN0207_L6.3mm_D2.5mm_P10.16mm_Horizontal; Tolerancia 1%
R10: 3k3; R_Axial_DIN0207_L6.3mm_D2.5mm_P10.16mm_Horizontal; Tolerancia 1%
RV1, RV4: 5k; Potentiometer_Bourns_3296W_Vertical
RV2: 2k; Potentiometer_Bourns_3296W_Vertical
RV3: 10k; Potentiometer_Bourns_3296W_Vertical
SW1: Decr; SW_PUSH_6mm_H7.3mm
SW2: Inc; SW_PUSH_6mm_H7.3mm
SW3: Acept; SW_PUSH_6mm_H7.3mm
U1: LCD-016N002L; LCD_pinsonly
U2: PSoC4_kit049_(CY8C4245AXI-483); PinSocket_2x22_P2.54mm_Vertical_3
U3: TL082; DIP-8_W10.16mm_LongPads

Connections:
+5V: J5.1, R2.2, RV1.1, U1.2 (VDD), U2.22 (VDD), U2.23 (VDD); also elsewhere on the board
+12V: U3.8 (V+); also elsewhere on the board
-12V: U3.4 (V-); also elsewhere on the board
/Control_y_salida/But_Acept: SW3.2, U2.25 (P1.7/SAR_CAP)
/Control_y_salida/But_Dec: SW1.2, U2.10 (P3.0)
/Control_y_salida/But_Inc: SW2.2, U2.2 (P2.0)
/Control_y_salida/IDAC_Neg: R4.2, R6.1, U2.30 (P1.2)
/Control_y_salida/IDAC_Pos: R7.1, U2.28 (P1.4), U3.5 (+)
/Control_y_salida/Iout: Q5.1 (C), Q6.1 (C); also elsewhere on the board
/Control_y_salida/LCD_D4: U1.11 (DB4), U2.40 (P0.0)
/Control_y_salida/LCD_D5: U1.12 (DB5), U2.39 (P0.1)
/Control_y_salida/LCD_D6: U1.13 (DB6), U2.38 (P0.2)
/Control_y_salida/LCD_D7: U1.14 (DB7), U2.37 (P0.3)
/Control_y_salida/LCD_E: U1.6 (E), U2.36 (P0.4)
/Control_y_salida/LCD_RS: U1.4 (RS), U2.35 (P0.5)
/Control_y_salida/LCD_R/W: U1.5 (R/~W), U2.34 (P0.6)
/Control_y_salida/Vi_Inv: J6.1, R5.2, U2.31 (P1.1)
/Control_y_salida/Vi_NoInv: R1.1, R2.1, R3.2, U2.32 (P1.0)
GND: R3.1, R5.1, R7.2, RV1.3, RV2.3, RV3.3, RV4.3, SW1.1, SW2.1, SW3.1, U1.1 (VSS), U2.1 (GND), U2.21 (GND), U2.24 (GND); also elsewhere on the board
unnamed: D1.1 (K), D2.2 (A), Q1.3 (E), Q2.3 (E), U3.2 (-)
unnamed: D1.2 (A), R9.2
unnamed: D2.1 (K), R10.2
unnamed: Q1.1 (C), Q3.1 (C), Q3.2 (B), Q5.2 (B)
unnamed: Q1.2 (B), Q2.2 (B), U3.1
unnamed: Q2.1 (C), Q4.1 (C), Q4.2 (B), Q6.2 (B)
unnamed: R1.2, U2.17 (P3.7)
unnamed: R4.1, RV2.1, RV2.2
unnamed: R6.2, R8.1, U3.6 (-)
unnamed: R8.2, U3.3 (+), U3.7
unnamed: R9.1, RV3.1, RV3.2
unnamed: R10.1, RV4.1, RV4.2
unnamed: RV1.2, U1.3 (VO)
VCC: Q3.3 (E), Q5.3 (E); also elsewhere on the board
VEE: Q4.3 (E), Q6.3 (E); also elsewhere on the board

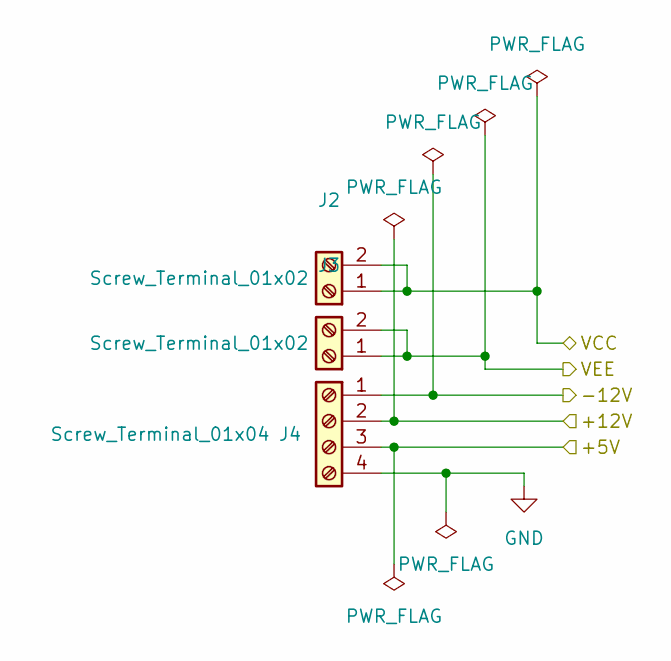
[picture p21: schematic Fuente.kicad_sch, Fuente_flyback_multisalida]

Parts:
J2, J3: Screw_Terminal_01x02; TerminalBlock_bornier-2_P5.08mm
J4: Screw_Terminal_01x04; TerminalBlock_bornier-4_P5.08mm

Connections:
+5V: J4.3; also elsewhere on the board
+12V: J4.2; also elsewhere on the board
-12V: J4.1; also elsewhere on the board
GND: J4.4; also elsewhere on the board
VCC: J2.1, J2.2; also elsewhere on the board
VEE: J3.1, J3.2; also elsewhere on the board

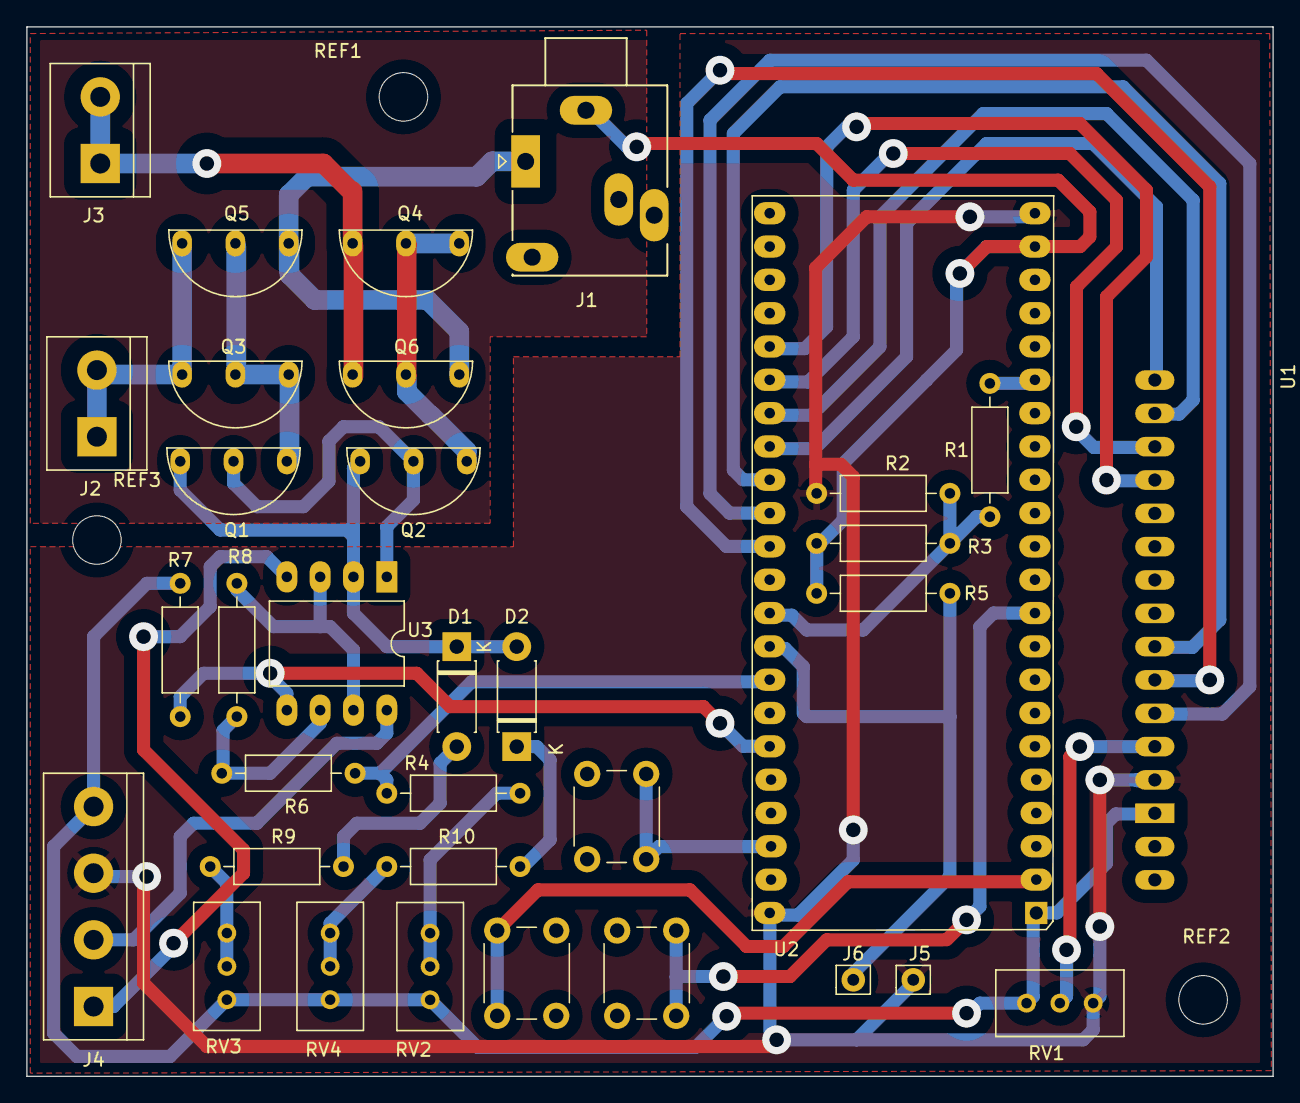
[picture p22: board Control_Fuente_de_Corrientes.kicad_pcb from above]

Board: 2 copper layers, 95.0 x 80.0 mm, 37 parts (0 on the bottom side), 34 nets.

Other parts of the board:
REF1, REF2, REF3: MountingHole_3.7mm
