jeremiasadrian/MIB_sistema_p_realimentacion_haptica/Esquematicos-y-PCB/Proyecto_KiCAD_Fuente-de-Alimentación/Puente_H.kicad_pcb

## KiCad design Esquematicos-y-PCB/Proyecto_KiCAD_Fuente-de-Alimentación/Puente_H.kicad_pcb (2024-03-17)

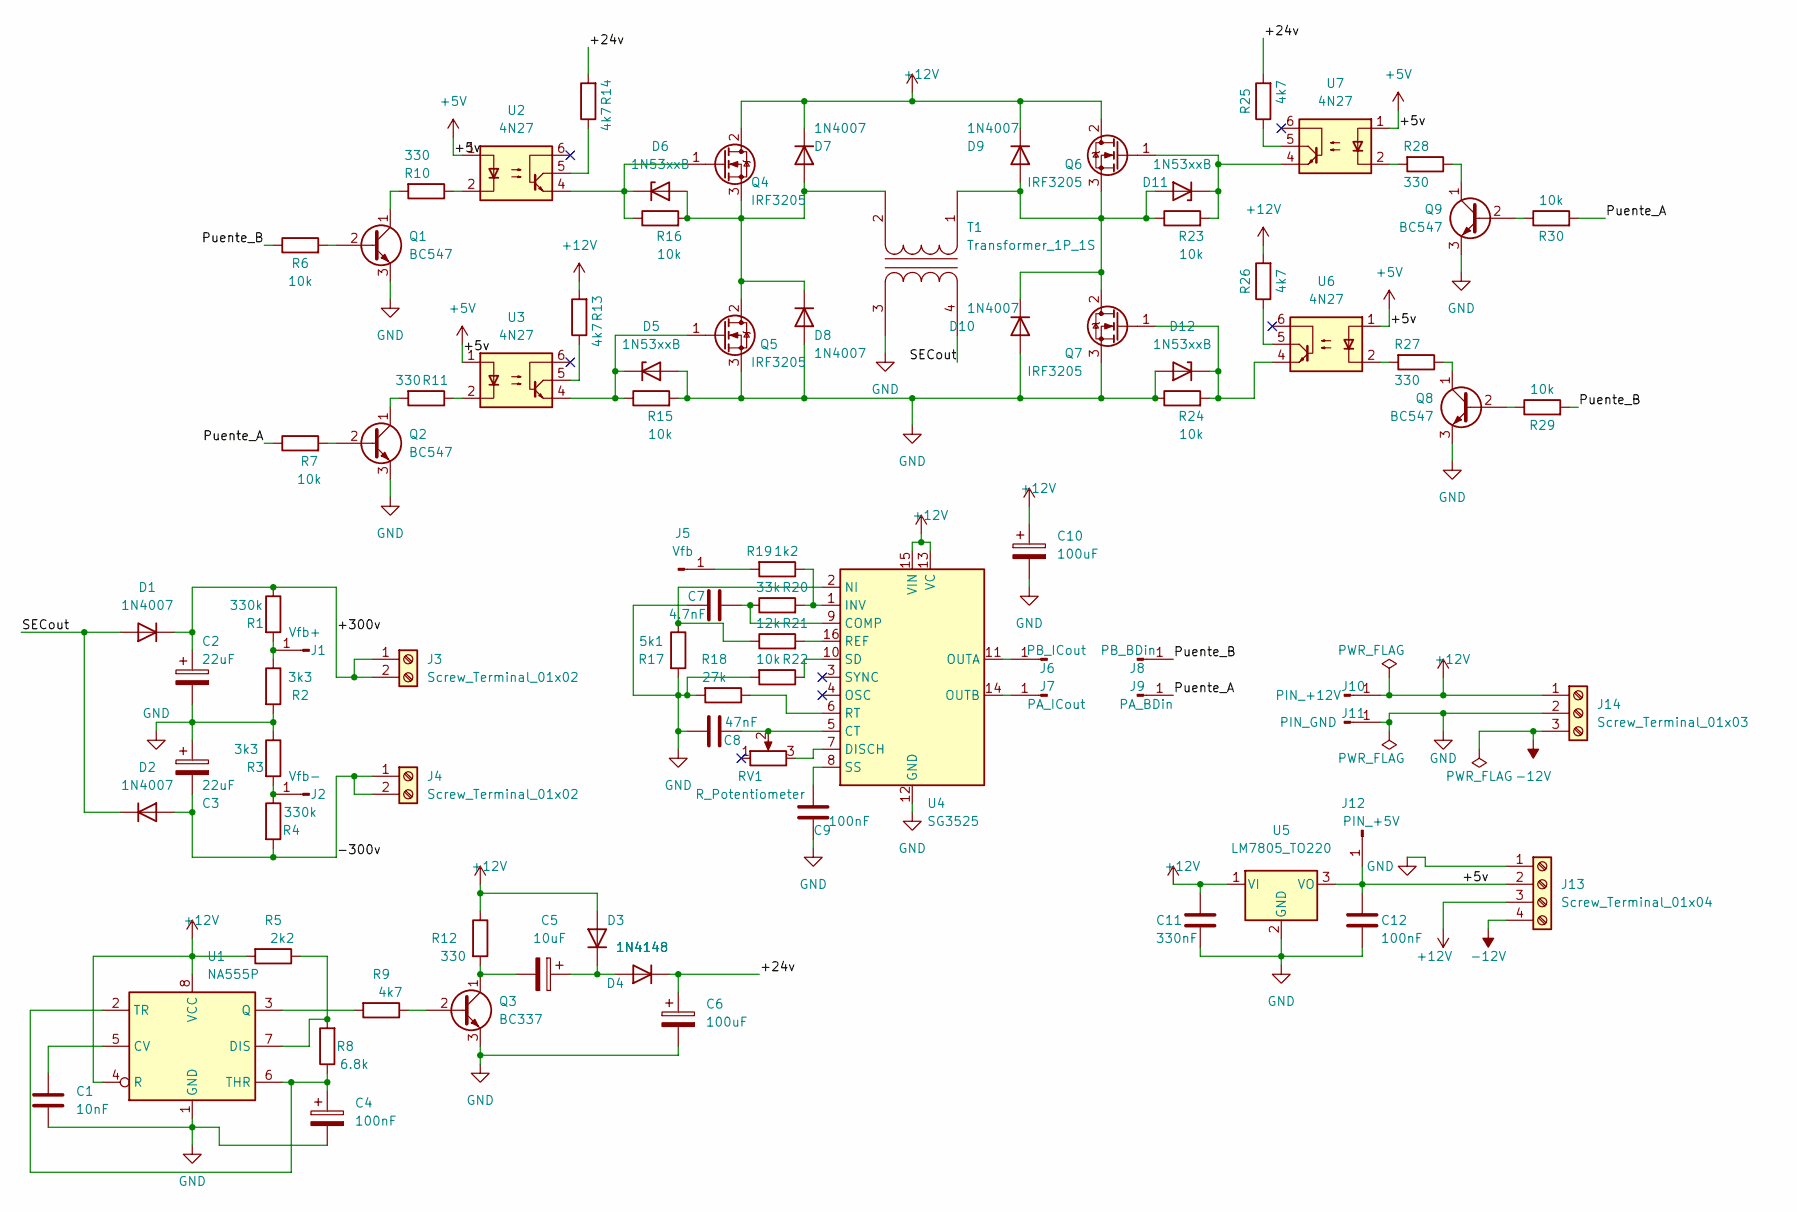
[picture p23: schematic Puente_H.kicad_sch, Puente_H_Fuente_AT_SCH]

Parts:
C1: 10nF; C_Disc_D5.0mm_W2.5mm_P2.50mm
C2, C3: 22uF; CP_Radial_D16.0mm_P7.50mm
C4, C9, C12: 100nF; C_Disc_D5.0mm_W2.5mm_P2.50mm
C5: 10uF; CP_Radial_D6.3mm_P2.50mm
C6, C10: 100uF; CP_Radial_D6.3mm_P2.50mm
C7: 4.7nF; C_Disc_D5.0mm_W2.5mm_P2.50mm
C8: 47nF; C_Disc_D5.0mm_W2.5mm_P2.50mm
C11: 330nF; C_Disc_D5.0mm_W2.5mm_P2.50mm
D1, D2, D7, D8, D9, D10: 1N4007; D_DO-41_SOD81_P10.16mm_Horizontal
D3, D4: 1N4148; D_DO-35_SOD27_P7.62mm_Horizontal
D5, D6, D11, D12: 1N53xxB; D_DO-35_SOD27_P7.62mm_Horizontal
J1: Vfb+; Pin_D0.7mm_L6.5mm_W1.8mm_FlatFork
J2: Vfb-; Pin_D0.7mm_L6.5mm_W1.8mm_FlatFork
J3, J4: Screw_Terminal_01x02; TerminalBlock_bornier-2_P5.08mm
J5: Vfb; Pin_D0.7mm_L6.5mm_W1.8mm_FlatFork
J6: PB_ICout; Pin_D0.7mm_L6.5mm_W1.8mm_FlatFork
J7: PA_ICout; Pin_D0.7mm_L6.5mm_W1.8mm_FlatFork
J8: PB_BDin; Pin_D0.7mm_L6.5mm_W1.8mm_FlatFork
J9: PA_BDin; Pin_D0.7mm_L6.5mm_W1.8mm_FlatFork
J10: PIN_+12V; Pin_D0.7mm_L6.5mm_W1.8mm_FlatFork
J11: PIN_GND; Pin_D0.7mm_L6.5mm_W1.8mm_FlatFork
J12: PIN_+5V; Pin_D0.7mm_L6.5mm_W1.8mm_FlatFork
J13: Screw_Terminal_01x04; TerminalBlock_bornier-4_P5.08mm
J14: Screw_Terminal_01x03; TerminalBlock_bornier-3_P5.08mm
Q1, Q2, Q8, Q9: BC547; TO-92_Inline_Wide
Q3: BC337; TO-92_Inline_Wide
Q4, Q5, Q6, Q7: IRF3205; TO-220-3_Vertical
R1, R4: 330k; R_Axial_DIN0207_L6.3mm_D2.5mm_P7.62mm_Horizontal
R2, R3: 3k3; R_Axial_DIN0207_L6.3mm_D2.5mm_P7.62mm_Horizontal
R5: 2k2; R_Axial_DIN0207_L6.3mm_D2.5mm_P7.62mm_Horizontal
R6, R7, R15, R16, R22, R23, R24, R29, R30: 10k; R_Axial_DIN0207_L6.3mm_D2.5mm_P7.62mm_Horizontal
R8: 6.8k; R_Axial_DIN0207_L6.3mm_D2.5mm_P7.62mm_Horizontal
R9, R13, R14, R25, R26: 4k7; R_Axial_DIN0207_L6.3mm_D2.5mm_P7.62mm_Horizontal
R10, R11, R12, R27, R28: 330; R_Axial_DIN0207_L6.3mm_D2.5mm_P7.62mm_Horizontal
R17: 5k1; R_Axial_DIN0207_L6.3mm_D2.5mm_P7.62mm_Horizontal
R18: 27k; R_Axial_DIN0207_L6.3mm_D2.5mm_P7.62mm_Horizontal
R19: 1k2; R_Axial_DIN0207_L6.3mm_D2.5mm_P7.62mm_Horizontal
R20: 33k; R_Axial_DIN0207_L6.3mm_D2.5mm_P7.62mm_Horizontal
R21: 12k; R_Axial_DIN0207_L6.3mm_D2.5mm_P7.62mm_Horizontal
RV1: R_Potentiometer; Potentiometer_Bourns_3296W_Vertical
T1: Transformer_1P_1S; Transformer_1S_2P
U1: NA555P; DIP-8_W7.62mm
U2, U3, U6, U7: 4N27; DIP-6_W7.62mm
U4: SG3525; DIP-16_W7.62mm_LongPads
U5: LM7805_TO220; TO-220-3_Vertical

Connections:
+5V: C12.1, J12.1, J13.2, U2.1, U3.1, U5.3 (VO), U6.1, U7.1
+12V: C10.1, C11.1, D3.2 (A), D7.1 (K), D9.1 (K), J10.1, J13.3, J14.1, Q4.2 (D), Q6.2 (D), R5.2, R12.1, R13.2, R26.2, U1.4 (R), U1.8 (VCC), U4.13 (VC), U4.15 (VIN), U5.1 (VI)
-12V: J13.4, J14.3
/+24v: C6.1, D4.1 (K), R14.2, R25.2
/+300v: C2.1, D1.1 (K), J3.1, J3.2, R1.1
/-300v: C3.2, D2.2 (A), J4.1, J4.2, R4.2
/Puente_A: J9.1, R7.1, R30.2
/Puente_B: J8.1, R6.1, R29.2
/SECout: D1.2 (A), D2.1 (K), T1.4 (SB)
GND: C1.2, C2.2, C3.1, C4.2, C6.2, C7.2, C8.1, C9.1, C10.2, C11.2, C12.2, D5.2 (A), D8.2 (A), D10.2 (A), D12.2 (A), J11.1, J13.1, J14.2, Q1.3 (E), Q2.3 (E), Q3.3 (E), Q5.3 (S), Q7.3 (S), Q8.3 (E), Q9.3 (E), R2.2, R3.1, R15.2, R17.2, R18.2, R22.2, R24.1, T1.3 (SA), U1.1 (GND), U4.12 (GND), U5.2 (GND)
unnamed: C1.1, U1.5 (CV)
unnamed: C4.1, R8.1, U1.2 (TR), U1.6 (THR)
unnamed: C5.1, D3.1 (K), D4.2 (A)
unnamed: C5.2, Q3.1 (C), R12.2
unnamed: C7.1, R20.1, U4.9 (COMP)
unnamed: C8.2, RV1.2, U4.5 (CT)
unnamed: C9.2, U4.8 (SS)
unnamed: D5.1 (K), Q5.1 (G), R15.1, U3.4
unnamed: D6.1 (K), Q4.1 (G), R16.1, U2.4
unnamed: D6.2 (A), D7.2 (A), D8.1 (K), Q4.3 (S), Q5.2 (D), R16.2, T1.2 (AB)
unnamed: D9.2 (A), D10.1 (K), D11.2 (A), Q6.3 (S), Q7.2 (D), R23.1, T1.1 (AA)
unnamed: D11.1 (K), Q6.1 (G), R23.2, U7.4
unnamed: D12.1 (K), Q7.1 (G), R24.2, U6.4
unnamed: J1.1, R1.2, R2.1
unnamed: J2.1, R3.2, R4.1
unnamed: J5.1, R19.2
unnamed: J6.1, U4.11 (OUTA)
unnamed: J7.1, U4.14 (OUTB)
unnamed: Q1.1 (C), R10.2
unnamed: Q1.2 (B), R6.2
unnamed: Q2.1 (C), R11.2
unnamed: Q2.2 (B), R7.2
unnamed: Q3.2 (B), R9.1
unnamed: Q8.1 (C), R27.1
unnamed: Q8.2 (B), R29.1
unnamed: Q9.1 (C), R28.1
unnamed: Q9.2 (B), R30.1
unnamed: R5.1, R8.2, U1.7 (DIS)
unnamed: R9.2, U1.3 (Q)
unnamed: R10.1, U2.2
unnamed: R11.1, U3.2
unnamed: R13.1, U3.5
unnamed: R14.1, U2.5
unnamed: R17.1, R21.1, U4.2 (NI)
unnamed: R18.1, U4.6 (RT)
unnamed: R19.1, R20.2, U4.1 (INV)
unnamed: R21.2, U4.16 (REF)
unnamed: R22.1, U4.10 (SD)
unnamed: R25.1, U7.5
unnamed: R26.1, U6.5
unnamed: R27.2, U6.2
unnamed: R28.2, U7.2
unnamed: RV1.3, U4.7 (DISCH)

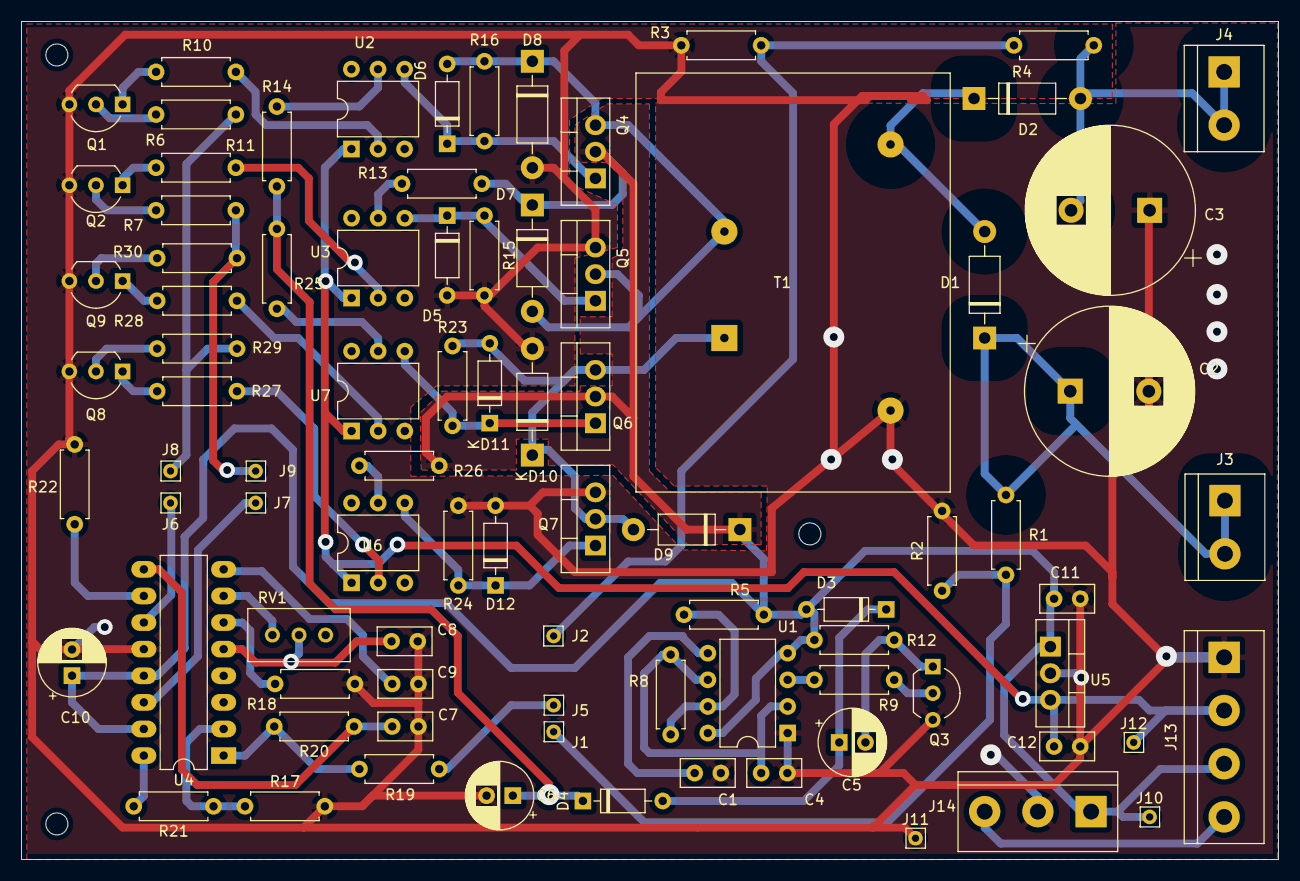
[picture p24: board Puente_H.kicad_pcb from above]

Board: 2 copper layers, 120.0 x 80.0 mm, 89 parts (0 on the bottom side), 53 nets.

Other parts of the board:
REF01, REF02, REF03: MountingHole_2.1mm
