jeremiasadrian/MIB_sistema_p_realimentacion_haptica/Codigo-fuente/COD2_PSoC4_Electroestimulador/Electroestimulador.cydsn/codegentemp/Pin_PWM.h

/*******************************************************************************
* File Name: Pin_PWM.h  
* Version 2.20
*
* Description:
*  This file contains Pin function prototypes and register defines
*
********************************************************************************
* Copyright 2008-2015, Cypress Semiconductor Corporation.  All rights reserved.
* You may use this file only in accordance with the license, terms, conditions, 
* disclaimers, and limitations in the end user license agreement accompanying 
* the software package with which this file was provided.
*******************************************************************************/

#if !defined(CY_PINS_Pin_PWM_H) /* Pins Pin_PWM_H */
#define CY_PINS_Pin_PWM_H

#include "cytypes.h"
#include "cyfitter.h"
#include "Pin_PWM_aliases.h"


/***************************************
*     Data Struct Definitions
***************************************/

/**
* \addtogroup group_structures
* @{
*/
    
/* Structure for sleep mode support */
typedef struct
{
    uint32 pcState; /**< State of the port control register */
    uint32 sioState; /**< State of the SIO configuration */
    uint32 usbState; /**< State of the USBIO regulator */
} Pin_PWM_BACKUP_STRUCT;

/** @} structures */


/***************************************
*        Function Prototypes             
***************************************/
/**
* \addtogroup group_general
* @{
*/
uint8   Pin_PWM_Read(void);
void    Pin_PWM_Write(uint8 value);
uint8   Pin_PWM_ReadDataReg(void);
#if defined(Pin_PWM__PC) || (CY_PSOC4_4200L) 
    void    Pin_PWM_SetDriveMode(uint8 mode);
#endif
void    Pin_PWM_SetInterruptMode(uint16 position, uint16 mode);
uint8   Pin_PWM_ClearInterrupt(void);
/** @} general */

/**
* \addtogroup group_power
* @{
*/
void Pin_PWM_Sleep(void); 
void Pin_PWM_Wakeup(void);
/** @} power */


/***************************************
*           API Constants        
***************************************/
#if defined(Pin_PWM__PC) || (CY_PSOC4_4200L) 
    /* Drive Modes */
    #define Pin_PWM_DRIVE_MODE_BITS        (3)
    #define Pin_PWM_DRIVE_MODE_IND_MASK    (0xFFFFFFFFu >> (32 - Pin_PWM_DRIVE_MODE_BITS))

    /**
    * \addtogroup group_constants
    * @{
    */
        /** \addtogroup driveMode Drive mode constants
         * \brief Constants to be passed as "mode" parameter in the Pin_PWM_SetDriveMode() function.
         *  @{
         */
        #define Pin_PWM_DM_ALG_HIZ         (0x00u) /**< \brief High Impedance Analog   */
        #define Pin_PWM_DM_DIG_HIZ         (0x01u) /**< \brief High Impedance Digital  */
        #define Pin_PWM_DM_RES_UP          (0x02u) /**< \brief Resistive Pull Up       */
        #define Pin_PWM_DM_RES_DWN         (0x03u) /**< \brief Resistive Pull Down     */
        #define Pin_PWM_DM_OD_LO           (0x04u) /**< \brief Open Drain, Drives Low  */
        #define Pin_PWM_DM_OD_HI           (0x05u) /**< \brief Open Drain, Drives High */
        #define Pin_PWM_DM_STRONG          (0x06u) /**< \brief Strong Drive            */
        #define Pin_PWM_DM_RES_UPDWN       (0x07u) /**< \brief Resistive Pull Up/Down  */
        /** @} driveMode */
    /** @} group_constants */
#endif

/* Digital Port Constants */
#define Pin_PWM_MASK               Pin_PWM__MASK
#define Pin_PWM_SHIFT              Pin_PWM__SHIFT
#define Pin_PWM_WIDTH              1u

/**
* \addtogroup group_constants
* @{
*/
    /** \addtogroup intrMode Interrupt constants
     * \brief Constants to be passed as "mode" parameter in Pin_PWM_SetInterruptMode() function.
     *  @{
     */
        #define Pin_PWM_INTR_NONE      ((uint16)(0x0000u)) /**< \brief Disabled             */
        #define Pin_PWM_INTR_RISING    ((uint16)(0x5555u)) /**< \brief Rising edge trigger  */
        #define Pin_PWM_INTR_FALLING   ((uint16)(0xaaaau)) /**< \brief Falling edge trigger */
        #define Pin_PWM_INTR_BOTH      ((uint16)(0xffffu)) /**< \brief Both edge trigger    */
    /** @} intrMode */
/** @} group_constants */

/* SIO LPM definition */
#if defined(Pin_PWM__SIO)
    #define Pin_PWM_SIO_LPM_MASK       (0x03u)
#endif

/* USBIO definitions */
#if !defined(Pin_PWM__PC) && (CY_PSOC4_4200L)
    #define Pin_PWM_USBIO_ENABLE               ((uint32)0x80000000u)
    #define Pin_PWM_USBIO_DISABLE              ((uint32)(~Pin_PWM_USBIO_ENABLE))
    #define Pin_PWM_USBIO_SUSPEND_SHIFT        CYFLD_USBDEVv2_USB_SUSPEND__OFFSET
    #define Pin_PWM_USBIO_SUSPEND_DEL_SHIFT    CYFLD_USBDEVv2_USB_SUSPEND_DEL__OFFSET
    #define Pin_PWM_USBIO_ENTER_SLEEP          ((uint32)((1u << Pin_PWM_USBIO_SUSPEND_SHIFT) \
                                                        | (1u << Pin_PWM_USBIO_SUSPEND_DEL_SHIFT)))
    #define Pin_PWM_USBIO_EXIT_SLEEP_PH1       ((uint32)~((uint32)(1u << Pin_PWM_USBIO_SUSPEND_SHIFT)))
    #define Pin_PWM_USBIO_EXIT_SLEEP_PH2       ((uint32)~((uint32)(1u << Pin_PWM_USBIO_SUSPEND_DEL_SHIFT)))
    #define Pin_PWM_USBIO_CR1_OFF              ((uint32)0xfffffffeu)
#endif


/***************************************
*             Registers        
***************************************/
/* Main Port Registers */
#if defined(Pin_PWM__PC)
    /* Port Configuration */
    #define Pin_PWM_PC                 (* (reg32 *) Pin_PWM__PC)
#endif
/* Pin State */
#define Pin_PWM_PS                     (* (reg32 *) Pin_PWM__PS)
/* Data Register */
#define Pin_PWM_DR                     (* (reg32 *) Pin_PWM__DR)
/* Input Buffer Disable Override */
#define Pin_PWM_INP_DIS                (* (reg32 *) Pin_PWM__PC2)

/* Interrupt configuration Registers */
#define Pin_PWM_INTCFG                 (* (reg32 *) Pin_PWM__INTCFG)
#define Pin_PWM_INTSTAT                (* (reg32 *) Pin_PWM__INTSTAT)

/* "Interrupt cause" register for Combined Port Interrupt (AllPortInt) in GSRef component */
#if defined (CYREG_GPIO_INTR_CAUSE)
    #define Pin_PWM_INTR_CAUSE         (* (reg32 *) CYREG_GPIO_INTR_CAUSE)
#endif

/* SIO register */
#if defined(Pin_PWM__SIO)
    #define Pin_PWM_SIO_REG            (* (reg32 *) Pin_PWM__SIO)
#endif /* (Pin_PWM__SIO_CFG) */

/* USBIO registers */
#if !defined(Pin_PWM__PC) && (CY_PSOC4_4200L)
    #define Pin_PWM_USB_POWER_REG       (* (reg32 *) CYREG_USBDEVv2_USB_POWER_CTRL)
    #define Pin_PWM_CR1_REG             (* (reg32 *) CYREG_USBDEVv2_CR1)
    #define Pin_PWM_USBIO_CTRL_REG      (* (reg32 *) CYREG_USBDEVv2_USB_USBIO_CTRL)
#endif    
    
    
/***************************************
* The following code is DEPRECATED and 
* must not be used in new designs.
***************************************/
/**
* \addtogroup group_deprecated
* @{
*/
#define Pin_PWM_DRIVE_MODE_SHIFT       (0x00u)
#define Pin_PWM_DRIVE_MODE_MASK        (0x07u << Pin_PWM_DRIVE_MODE_SHIFT)
/** @} deprecated */

#endif /* End Pins Pin_PWM_H */


/* [] END OF FILE */
