jeremiasadrian/MIB_sistema_p_realimentacion_haptica/Codigo-fuente/COD2_PSoC4_Electroestimulador/Electroestimulador.cydsn/codegentemp/Pin_PWM_aliases.h

/*******************************************************************************
* File Name: Pin_PWM.h  
* Version 2.20
*
* Description:
*  This file contains the Alias definitions for Per-Pin APIs in cypins.h. 
*  Information on using these APIs can be found in the System Reference Guide.
*
* Note:
*
********************************************************************************
* Copyright 2008-2015, Cypress Semiconductor Corporation.  All rights reserved.
* You may use this file only in accordance with the license, terms, conditions, 
* disclaimers, and limitations in the end user license agreement accompanying 
* the software package with which this file was provided.
*******************************************************************************/

#if !defined(CY_PINS_Pin_PWM_ALIASES_H) /* Pins Pin_PWM_ALIASES_H */
#define CY_PINS_Pin_PWM_ALIASES_H

#include "cytypes.h"
#include "cyfitter.h"
#include "cypins.h"


/***************************************
*              Constants        
***************************************/
#define Pin_PWM_0			(Pin_PWM__0__PC)
#define Pin_PWM_0_PS		(Pin_PWM__0__PS)
#define Pin_PWM_0_PC		(Pin_PWM__0__PC)
#define Pin_PWM_0_DR		(Pin_PWM__0__DR)
#define Pin_PWM_0_SHIFT	(Pin_PWM__0__SHIFT)
#define Pin_PWM_0_INTR	((uint16)((uint16)0x0003u << (Pin_PWM__0__SHIFT*2u)))

#define Pin_PWM_INTR_ALL	 ((uint16)(Pin_PWM_0_INTR))


#endif /* End Pins Pin_PWM_ALIASES_H */


/* [] END OF FILE */
