jeremiasadrian/MIB_sistema_p_realimentacion_haptica/Codigo-fuente/COD2_PSoC4_Electroestimulador/Electroestimulador.cydsn/codegentemp/PWM_INT.c

/*******************************************************************************
* File Name: PWM_INT.c  
* Version 1.70
*
*  Description:
*   API for controlling the state of an interrupt.
*
*
*  Note:
*
********************************************************************************
* Copyright 2008-2015, Cypress Semiconductor Corporation.  All rights reserved.
* You may use this file only in accordance with the license, terms, conditions, 
* disclaimers, and limitations in the end user license agreement accompanying 
* the software package with which this file was provided.
*******************************************************************************/


#include <cydevice_trm.h>
#include <CyLib.h>
#include <PWM_INT.h>
#include "cyapicallbacks.h"

#if !defined(PWM_INT__REMOVED) /* Check for removal by optimization */

/*******************************************************************************
*  Place your includes, defines and code here 
********************************************************************************/
/* `#START PWM_INT_intc` */

/* `#END` */

extern cyisraddress CyRamVectors[CYINT_IRQ_BASE + CY_NUM_INTERRUPTS];

/* Declared in startup, used to set unused interrupts to. */
CY_ISR_PROTO(IntDefaultHandler);


/*******************************************************************************
* Function Name: PWM_INT_Start
********************************************************************************
*
* Summary:
*  Set up the interrupt and enable it. This function disables the interrupt, 
*  sets the default interrupt vector, sets the priority from the value in the
*  Design Wide Resources Interrupt Editor, then enables the interrupt to the 
*  interrupt controller.
*
* Parameters:  
*   None
*
* Return:
*   None
*
*******************************************************************************/
void PWM_INT_Start(void)
{
    /* For all we know the interrupt is active. */
    PWM_INT_Disable();

    /* Set the ISR to point to the PWM_INT Interrupt. */
    PWM_INT_SetVector(&PWM_INT_Interrupt);

    /* Set the priority. */
    PWM_INT_SetPriority((uint8)PWM_INT_INTC_PRIOR_NUMBER);

    /* Enable it. */
    PWM_INT_Enable();
}


/*******************************************************************************
* Function Name: PWM_INT_StartEx
********************************************************************************
*
* Summary:
*  Sets up the interrupt and enables it. This function disables the interrupt,
*  sets the interrupt vector based on the address passed in, sets the priority 
*  from the value in the Design Wide Resources Interrupt Editor, then enables 
*  the interrupt to the interrupt controller.
*  
*  When defining ISR functions, the CY_ISR and CY_ISR_PROTO macros should be 
*  used to provide consistent definition across compilers:
*  
*  Function definition example:
*   CY_ISR(MyISR)
*   {
*   }
*   Function prototype example:
*   CY_ISR_PROTO(MyISR);
*
* Parameters:  
*   address: Address of the ISR to set in the interrupt vector table.
*
* Return:
*   None
*
*******************************************************************************/
void PWM_INT_StartEx(cyisraddress address)
{
    /* For all we know the interrupt is active. */
    PWM_INT_Disable();

    /* Set the ISR to point to the PWM_INT Interrupt. */
    PWM_INT_SetVector(address);

    /* Set the priority. */
    PWM_INT_SetPriority((uint8)PWM_INT_INTC_PRIOR_NUMBER);

    /* Enable it. */
    PWM_INT_Enable();
}


/*******************************************************************************
* Function Name: PWM_INT_Stop
********************************************************************************
*
* Summary:
*   Disables and removes the interrupt.
*
* Parameters:  
*   None
*
* Return:
*   None
*
*******************************************************************************/
void PWM_INT_Stop(void)
{
    /* Disable this interrupt. */
    PWM_INT_Disable();

    /* Set the ISR to point to the passive one. */
    PWM_INT_SetVector(&IntDefaultHandler);
}


/*******************************************************************************
* Function Name: PWM_INT_Interrupt
********************************************************************************
*
* Summary:
*   The default Interrupt Service Routine for PWM_INT.
*
*   Add custom code between the START and END comments to keep the next version
*   of this file from over-writing your code.
*
*   Note You may use either the default ISR by using this API, or you may define
*   your own separate ISR through ISR_StartEx().
*
* Parameters:  
*   None
*
* Return:
*   None
*
*******************************************************************************/
CY_ISR(PWM_INT_Interrupt)
{
    #ifdef PWM_INT_INTERRUPT_INTERRUPT_CALLBACK
        PWM_INT_Interrupt_InterruptCallback();
    #endif /* PWM_INT_INTERRUPT_INTERRUPT_CALLBACK */ 

    /*  Place your Interrupt code here. */
    /* `#START PWM_INT_Interrupt` */

    /* `#END` */
}


/*******************************************************************************
* Function Name: PWM_INT_SetVector
********************************************************************************
*
* Summary:
*   Change the ISR vector for the Interrupt. Note calling PWM_INT_Start
*   will override any effect this method would have had. To set the vector 
*   before the component has been started use PWM_INT_StartEx instead.
* 
*   When defining ISR functions, the CY_ISR and CY_ISR_PROTO macros should be 
*   used to provide consistent definition across compilers:
*
*   Function definition example:
*   CY_ISR(MyISR)
*   {
*   }
*
*   Function prototype example:
*     CY_ISR_PROTO(MyISR);
*
* Parameters:
*   address: Address of the ISR to set in the interrupt vector table.
*
* Return:
*   None
*
*******************************************************************************/
void PWM_INT_SetVector(cyisraddress address)
{
    CyRamVectors[CYINT_IRQ_BASE + PWM_INT__INTC_NUMBER] = address;
}


/*******************************************************************************
* Function Name: PWM_INT_GetVector
********************************************************************************
*
* Summary:
*   Gets the "address" of the current ISR vector for the Interrupt.
*
* Parameters:
*   None
*
* Return:
*   Address of the ISR in the interrupt vector table.
*
*******************************************************************************/
cyisraddress PWM_INT_GetVector(void)
{
    return CyRamVectors[CYINT_IRQ_BASE + PWM_INT__INTC_NUMBER];
}


/*******************************************************************************
* Function Name: PWM_INT_SetPriority
********************************************************************************
*
* Summary:
*   Sets the Priority of the Interrupt. 
*
*   Note calling PWM_INT_Start or PWM_INT_StartEx will 
*   override any effect this API would have had. This API should only be called
*   after PWM_INT_Start or PWM_INT_StartEx has been called. 
*   To set the initial priority for the component, use the Design-Wide Resources
*   Interrupt Editor.
*
*   Note This API has no effect on Non-maskable interrupt NMI).
*
* Parameters:
*   priority: Priority of the interrupt, 0 being the highest priority
*             PSoC 3 and PSoC 5LP: Priority is from 0 to 7.
*             PSoC 4: Priority is from 0 to 3.
*
* Return:
*   None
*
*******************************************************************************/
void PWM_INT_SetPriority(uint8 priority)
{
	uint8 interruptState;
    uint32 priorityOffset = ((PWM_INT__INTC_NUMBER % 4u) * 8u) + 6u;
    
	interruptState = CyEnterCriticalSection();
    *PWM_INT_INTC_PRIOR = (*PWM_INT_INTC_PRIOR & (uint32)(~PWM_INT__INTC_PRIOR_MASK)) |
                                    ((uint32)priority << priorityOffset);
	CyExitCriticalSection(interruptState);
}


/*******************************************************************************
* Function Name: PWM_INT_GetPriority
********************************************************************************
*
* Summary:
*   Gets the Priority of the Interrupt.
*
* Parameters:
*   None
*
* Return:
*   Priority of the interrupt, 0 being the highest priority
*    PSoC 3 and PSoC 5LP: Priority is from 0 to 7.
*    PSoC 4: Priority is from 0 to 3.
*
*******************************************************************************/
uint8 PWM_INT_GetPriority(void)
{
    uint32 priority;
	uint32 priorityOffset = ((PWM_INT__INTC_NUMBER % 4u) * 8u) + 6u;

    priority = (*PWM_INT_INTC_PRIOR & PWM_INT__INTC_PRIOR_MASK) >> priorityOffset;

    return (uint8)priority;
}


/*******************************************************************************
* Function Name: PWM_INT_Enable
********************************************************************************
*
* Summary:
*   Enables the interrupt to the interrupt controller. Do not call this function
*   unless ISR_Start() has been called or the functionality of the ISR_Start() 
*   function, which sets the vector and the priority, has been called.
*
* Parameters:
*   None
*
* Return:
*   None
*
*******************************************************************************/
void PWM_INT_Enable(void)
{
    /* Enable the general interrupt. */
    *PWM_INT_INTC_SET_EN = PWM_INT__INTC_MASK;
}


/*******************************************************************************
* Function Name: PWM_INT_GetState
********************************************************************************
*
* Summary:
*   Gets the state (enabled, disabled) of the Interrupt.
*
* Parameters:
*   None
*
* Return:
*   1 if enabled, 0 if disabled.
*
*******************************************************************************/
uint8 PWM_INT_GetState(void)
{
    /* Get the state of the general interrupt. */
    return ((*PWM_INT_INTC_SET_EN & (uint32)PWM_INT__INTC_MASK) != 0u) ? 1u:0u;
}


/*******************************************************************************
* Function Name: PWM_INT_Disable
********************************************************************************
*
* Summary:
*   Disables the Interrupt in the interrupt controller.
*
* Parameters:
*   None
*
* Return:
*   None
*
*******************************************************************************/
void PWM_INT_Disable(void)
{
    /* Disable the general interrupt. */
    *PWM_INT_INTC_CLR_EN = PWM_INT__INTC_MASK;
}


/*******************************************************************************
* Function Name: PWM_INT_SetPending
********************************************************************************
*
* Summary:
*   Causes the Interrupt to enter the pending state, a software method of
*   generating the interrupt.
*
* Parameters:
*   None
*
* Return:
*   None
*
* Side Effects:
*   If interrupts are enabled and the interrupt is set up properly, the ISR is
*   entered (depending on the priority of this interrupt and other pending 
*   interrupts).
*
*******************************************************************************/
void PWM_INT_SetPending(void)
{
    *PWM_INT_INTC_SET_PD = PWM_INT__INTC_MASK;
}


/*******************************************************************************
* Function Name: PWM_INT_ClearPending
********************************************************************************
*
* Summary:
*   Clears a pending interrupt in the interrupt controller.
*
*   Note Some interrupt sources are clear-on-read and require the block 
*   interrupt/status register to be read/cleared with the appropriate block API 
*   (GPIO, UART, and so on). Otherwise the ISR will continue to remain in 
*   pending state even though the interrupt itself is cleared using this API.
*
* Parameters:
*   None
*
* Return:
*   None
*
*******************************************************************************/
void PWM_INT_ClearPending(void)
{
    *PWM_INT_INTC_CLR_PD = PWM_INT__INTC_MASK;
}

#endif /* End check for removal by optimization */


/* [] END OF FILE */
