jeremiasadrian/MIB_sistema_p_realimentacion_haptica/Codigo-fuente/COD2_PSoC4_Electroestimulador/Electroestimulador.cydsn/codegentemp/Pin_PWM_PM.c

/*******************************************************************************
* File Name: Pin_PWM.c  
* Version 2.20
*
* Description:
*  This file contains APIs to set up the Pins component for low power modes.
*
* Note:
*
********************************************************************************
* Copyright 2015, Cypress Semiconductor Corporation.  All rights reserved.
* You may use this file only in accordance with the license, terms, conditions, 
* disclaimers, and limitations in the end user license agreement accompanying 
* the software package with which this file was provided.
*******************************************************************************/

#include "cytypes.h"
#include "Pin_PWM.h"

static Pin_PWM_BACKUP_STRUCT  Pin_PWM_backup = {0u, 0u, 0u};


/*******************************************************************************
* Function Name: Pin_PWM_Sleep
****************************************************************************//**
*
* \brief Stores the pin configuration and prepares the pin for entering chip 
*  deep-sleep/hibernate modes. This function applies only to SIO and USBIO pins.
*  It should not be called for GPIO or GPIO_OVT pins.
*
* <b>Note</b> This function is available in PSoC 4 only.
*
* \return 
*  None 
*  
* \sideeffect
*  For SIO pins, this function configures the pin input threshold to CMOS and
*  drive level to Vddio. This is needed for SIO pins when in device 
*  deep-sleep/hibernate modes.
*
* \funcusage
*  \snippet Pin_PWM_SUT.c usage_Pin_PWM_Sleep_Wakeup
*******************************************************************************/
void Pin_PWM_Sleep(void)
{
    #if defined(Pin_PWM__PC)
        Pin_PWM_backup.pcState = Pin_PWM_PC;
    #else
        #if (CY_PSOC4_4200L)
            /* Save the regulator state and put the PHY into suspend mode */
            Pin_PWM_backup.usbState = Pin_PWM_CR1_REG;
            Pin_PWM_USB_POWER_REG |= Pin_PWM_USBIO_ENTER_SLEEP;
            Pin_PWM_CR1_REG &= Pin_PWM_USBIO_CR1_OFF;
        #endif
    #endif
    #if defined(CYIPBLOCK_m0s8ioss_VERSION) && defined(Pin_PWM__SIO)
        Pin_PWM_backup.sioState = Pin_PWM_SIO_REG;
        /* SIO requires unregulated output buffer and single ended input buffer */
        Pin_PWM_SIO_REG &= (uint32)(~Pin_PWM_SIO_LPM_MASK);
    #endif  
}


/*******************************************************************************
* Function Name: Pin_PWM_Wakeup
****************************************************************************//**
*
* \brief Restores the pin configuration that was saved during Pin_Sleep(). This 
* function applies only to SIO and USBIO pins. It should not be called for
* GPIO or GPIO_OVT pins.
*
* For USBIO pins, the wakeup is only triggered for falling edge interrupts.
*
* <b>Note</b> This function is available in PSoC 4 only.
*
* \return 
*  None
*  
* \funcusage
*  Refer to Pin_PWM_Sleep() for an example usage.
*******************************************************************************/
void Pin_PWM_Wakeup(void)
{
    #if defined(Pin_PWM__PC)
        Pin_PWM_PC = Pin_PWM_backup.pcState;
    #else
        #if (CY_PSOC4_4200L)
            /* Restore the regulator state and come out of suspend mode */
            Pin_PWM_USB_POWER_REG &= Pin_PWM_USBIO_EXIT_SLEEP_PH1;
            Pin_PWM_CR1_REG = Pin_PWM_backup.usbState;
            Pin_PWM_USB_POWER_REG &= Pin_PWM_USBIO_EXIT_SLEEP_PH2;
        #endif
    #endif
    #if defined(CYIPBLOCK_m0s8ioss_VERSION) && defined(Pin_PWM__SIO)
        Pin_PWM_SIO_REG = Pin_PWM_backup.sioState;
    #endif
}


/* [] END OF FILE */
