jeremiasadrian/MIB_sistema_p_realimentacion_haptica/Codigo-fuente/COD2_PSoC4_Electroestimulador/Electroestimulador.cydsn/codegentemp/ACEP_INT.h

/*******************************************************************************
* File Name: ACEP_INT.h
* Version 1.70
*
*  Description:
*   Provides the function definitions for the Interrupt Controller.
*
*
********************************************************************************
* Copyright 2008-2015, Cypress Semiconductor Corporation.  All rights reserved.
* You may use this file only in accordance with the license, terms, conditions, 
* disclaimers, and limitations in the end user license agreement accompanying 
* the software package with which this file was provided.
*******************************************************************************/
#if !defined(CY_ISR_ACEP_INT_H)
#define CY_ISR_ACEP_INT_H


#include <cytypes.h>
#include <cyfitter.h>

/* Interrupt Controller API. */
void ACEP_INT_Start(void);
void ACEP_INT_StartEx(cyisraddress address);
void ACEP_INT_Stop(void);

CY_ISR_PROTO(ACEP_INT_Interrupt);

void ACEP_INT_SetVector(cyisraddress address);
cyisraddress ACEP_INT_GetVector(void);

void ACEP_INT_SetPriority(uint8 priority);
uint8 ACEP_INT_GetPriority(void);

void ACEP_INT_Enable(void);
uint8 ACEP_INT_GetState(void);
void ACEP_INT_Disable(void);

void ACEP_INT_SetPending(void);
void ACEP_INT_ClearPending(void);


/* Interrupt Controller Constants */

/* Address of the INTC.VECT[x] register that contains the Address of the ACEP_INT ISR. */
#define ACEP_INT_INTC_VECTOR            ((reg32 *) ACEP_INT__INTC_VECT)

/* Address of the ACEP_INT ISR priority. */
#define ACEP_INT_INTC_PRIOR             ((reg32 *) ACEP_INT__INTC_PRIOR_REG)

/* Priority of the ACEP_INT interrupt. */
#define ACEP_INT_INTC_PRIOR_NUMBER      ACEP_INT__INTC_PRIOR_NUM

/* Address of the INTC.SET_EN[x] byte to bit enable ACEP_INT interrupt. */
#define ACEP_INT_INTC_SET_EN            ((reg32 *) ACEP_INT__INTC_SET_EN_REG)

/* Address of the INTC.CLR_EN[x] register to bit clear the ACEP_INT interrupt. */
#define ACEP_INT_INTC_CLR_EN            ((reg32 *) ACEP_INT__INTC_CLR_EN_REG)

/* Address of the INTC.SET_PD[x] register to set the ACEP_INT interrupt state to pending. */
#define ACEP_INT_INTC_SET_PD            ((reg32 *) ACEP_INT__INTC_SET_PD_REG)

/* Address of the INTC.CLR_PD[x] register to clear the ACEP_INT interrupt. */
#define ACEP_INT_INTC_CLR_PD            ((reg32 *) ACEP_INT__INTC_CLR_PD_REG)



#endif /* CY_ISR_ACEP_INT_H */


/* [] END OF FILE */
