jeremiasadrian/MIB_sistema_p_realimentacion_haptica/(commit log)

2024-03-17 Se incorpora contenido inicial
    [BOM_Planilla.ods, Control_Fuente_de_Corrientes.csv, Control_Fuente_de_Corrientes.kicad_pcb, Control_Fuente_de_Corrientes.kicad_sch, Control_Fuente_de_Corrientes.step, Control_y_salida.kicad_sch, Electroestimulador.sdf, Fuente con SG3525 (UC2525).pdsprj]
2024-03-17 Se agregan datos de pruebas en "Resultados/Pruebas"
    [Regulación de Fuente de AT.xlsx, Respuesta de Opto 4N26A.xlsx]
2024-03-17 Agrega contenido inicial
    Incorpora contenido a todas las carpetas.
    [Caracterización del Nucleo de Ferrita (grande ATX).xlsx, SIM3_Fuente_de_corriente_1-(Proteus-8.13-SP1).pdsprj, SIM4_Fuente_de_corriente_2-(Proteus-8.13-SP1).pdsprj]
2024-03-17 cambio de formato en referencias
